evolutek/cartolutek-hardware/Hoop Interface/Output/hoop-interface.step

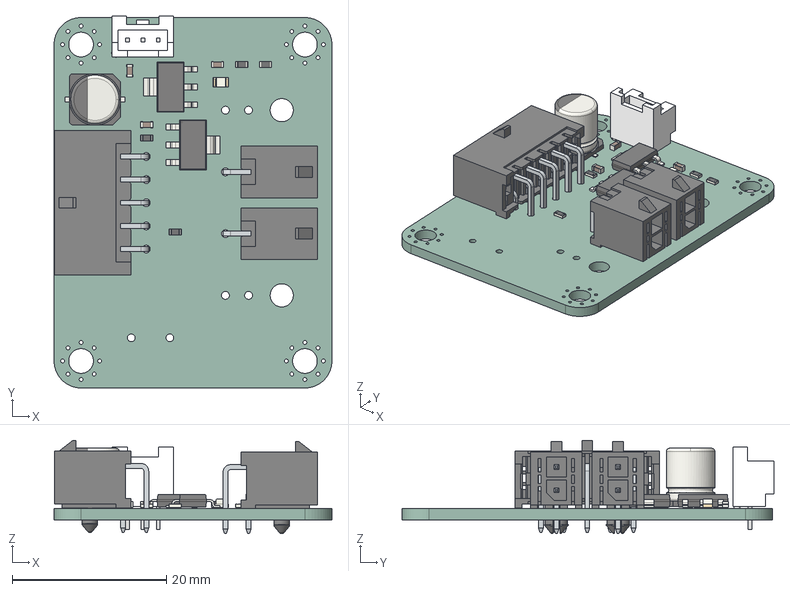
[picture p1: CAD file, 2026-03-06]
Hoop Interface/Output/hoop-interface.step
36.0 x 48.2 x 12.1 mm
6620xx21022_PIN_COURTE x 7
6620xx21022_PIN_LONGUE x 7
R_0603_1608Metric x 4
CP_Elec_6.3x7.7
SOT-223 x 2
C_0603_1608Metric x 3
LED_0805_2012Metric
B03B-PASK-1
hoop-interface_PCB
