evolutek/cartolutek-hardware/Mainboard/Output/Mainboard.pdf

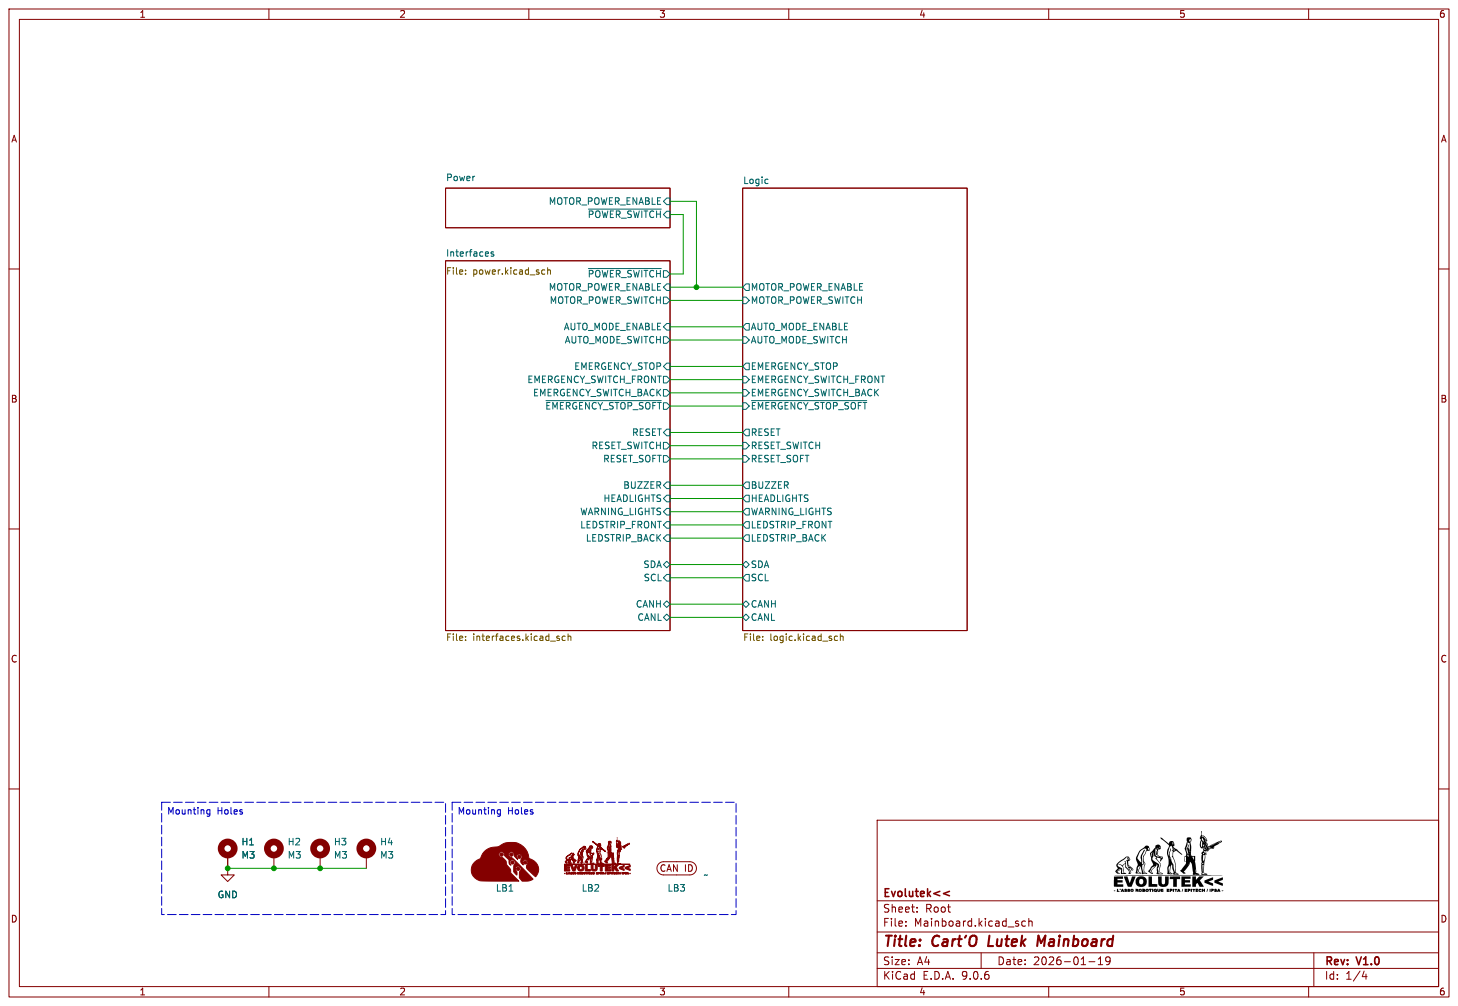
[picture p2: page 1]

~{POWER_SWITCH} Power File: power.kicad_sch MOTOR_POWER_ENABLE
Logic File: logic.kicad_sch CAN ID

LEDSTRIP_BACK
SDA CANL SCL CANH

File: Mainboard.kicad_sch Sheet: Root Evolutek<<

Id: 1/4 Title: Cart'O Lutek Mainboard

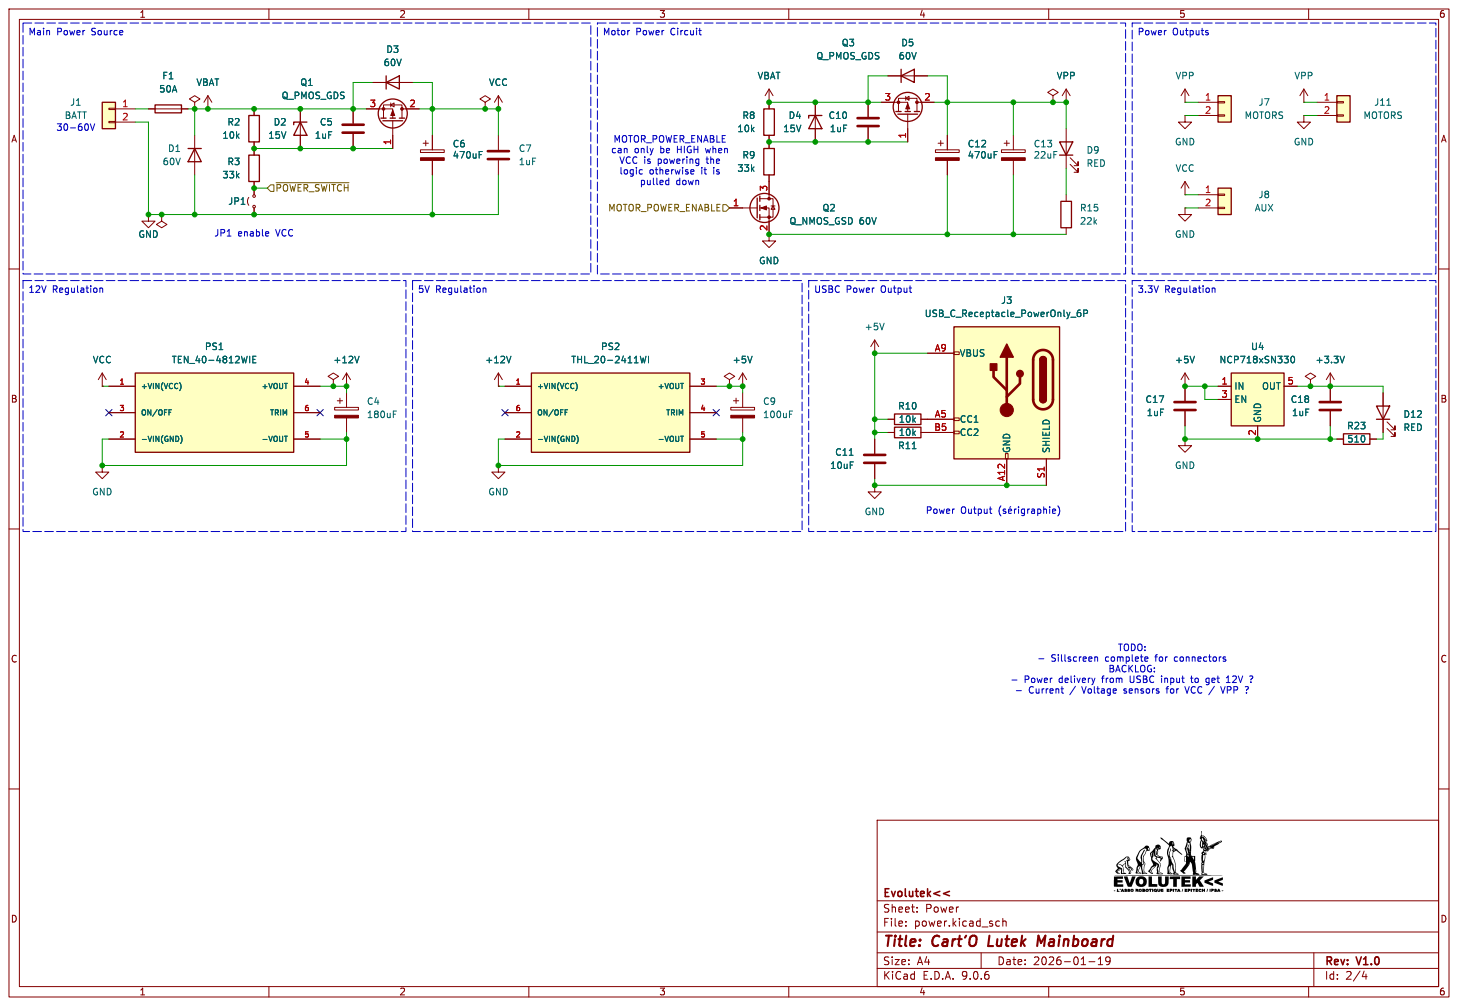
[picture p3: page 2]

- Current / Voltage sensors for VCC / VPP ? Power Output þÿ(sérigraphie) C6

can only be HIGH when VCC is powering the

File: power.kicad_sch Sheet: Power Evolutek<<

Id: 2/4 Title: Cart'O Lutek Mainboard

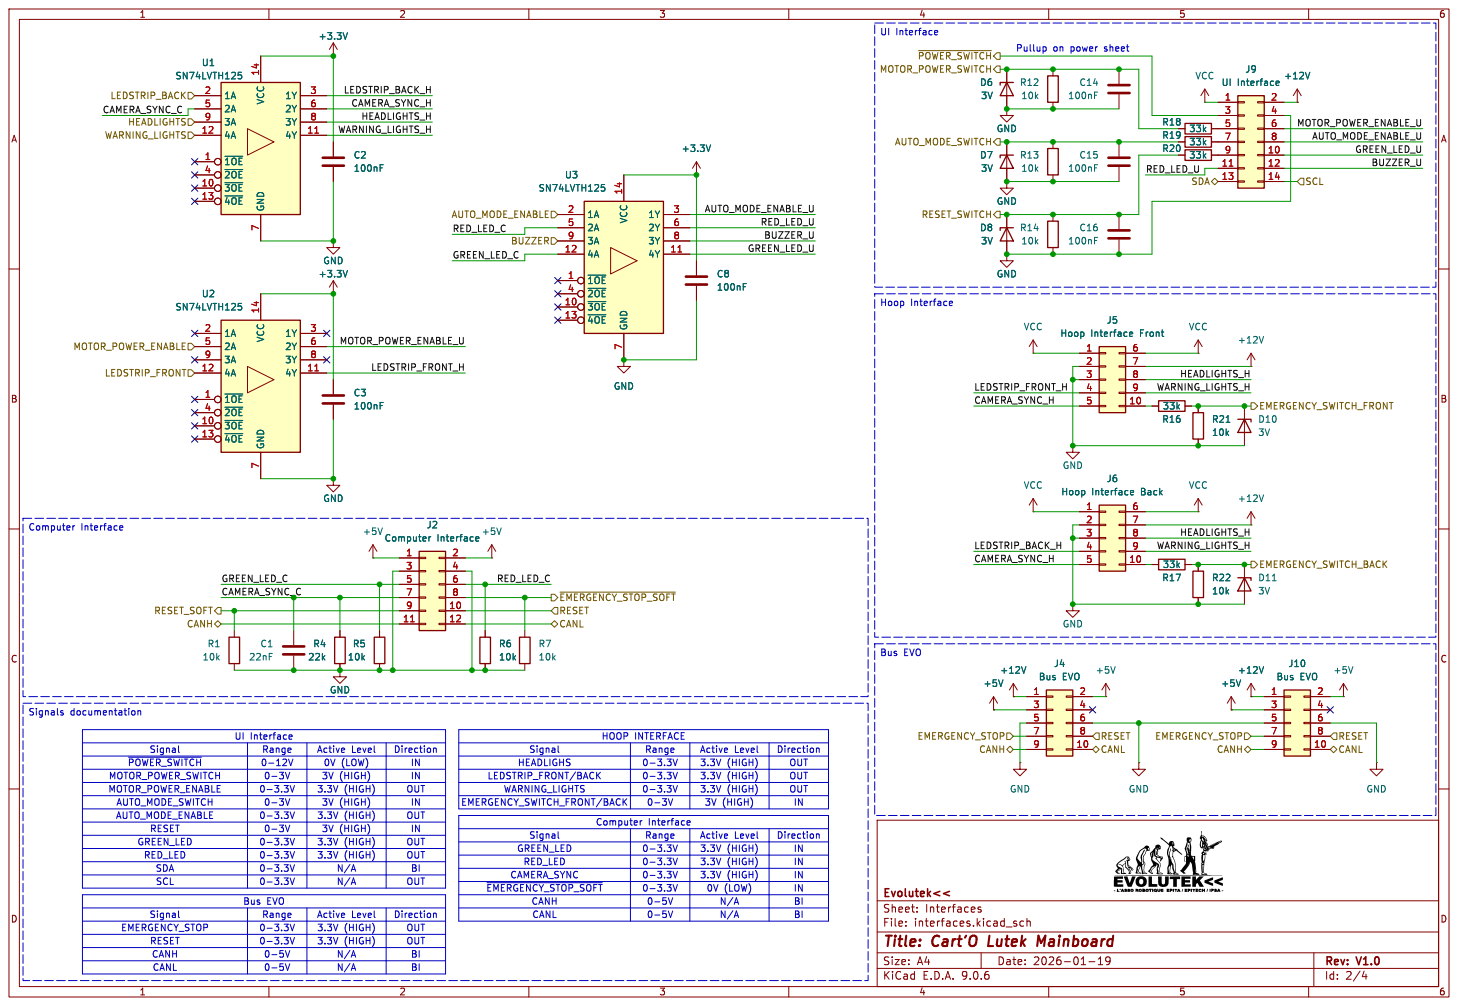
[picture p4: page 3]

Pullup on power sheet

Id: 2/4 Title: Cart'O Lutek Mainboard

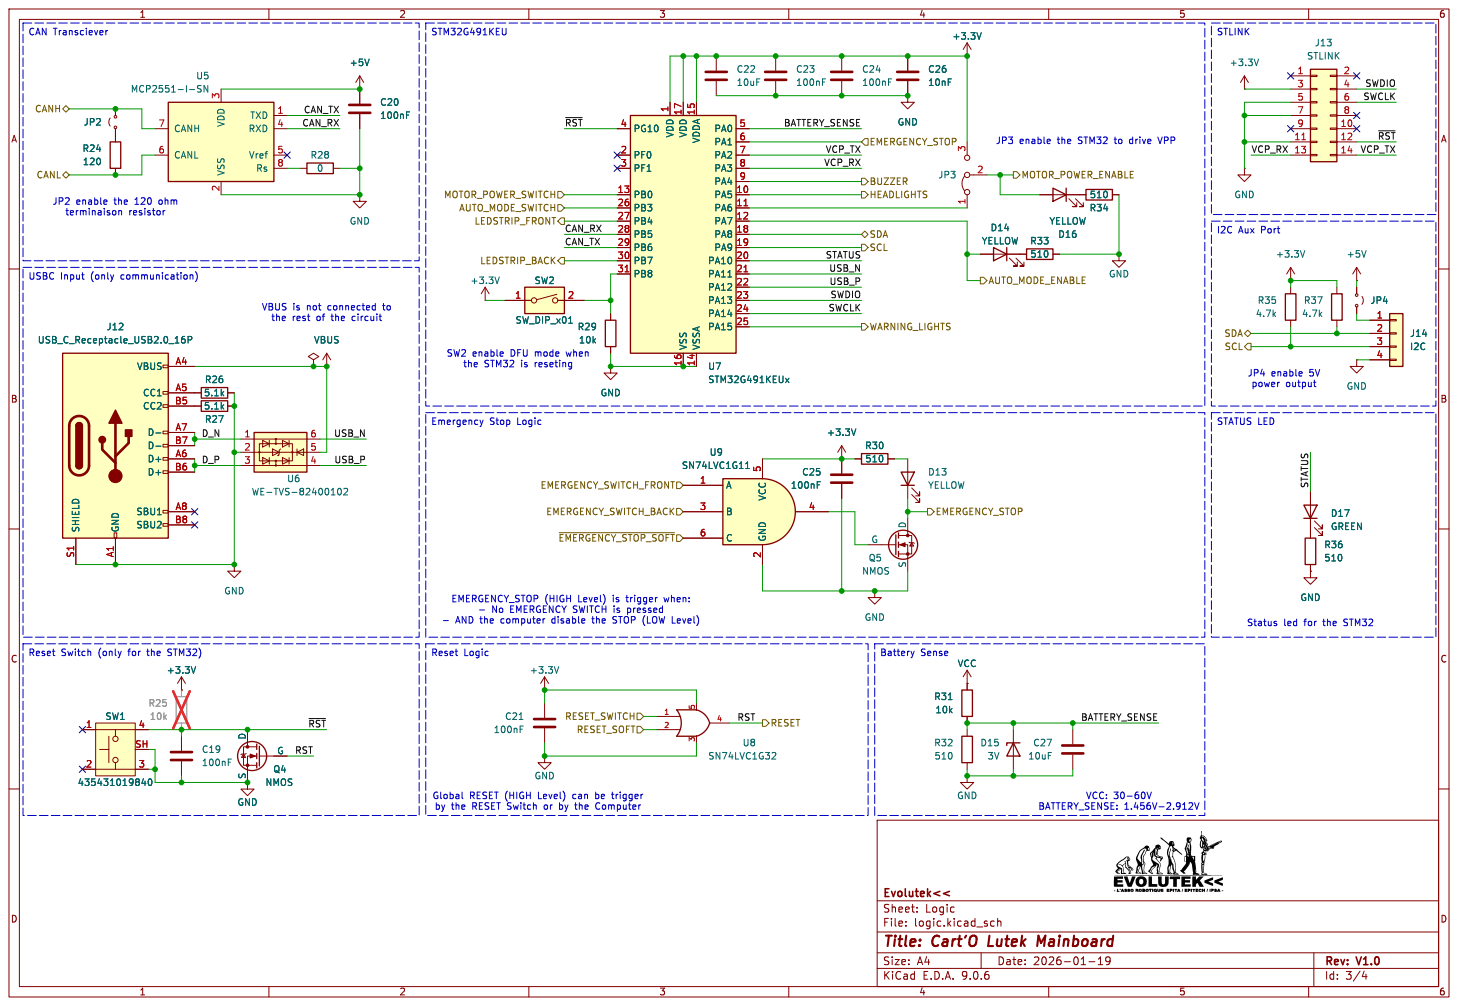
[picture p5: page 4]

1 VDD 17 VSS 16 VDDA 15 VSSA 14 PA0 5 PA1 6 PA2 7 PA3 8 PA4 9 PA5 10 PA6 11 PA7 12 PA8 18 PA9 19 PA10 20 PA11 21 PA12 22 PA13 23 PA14 24 PA15 25 J12 USB_C_Receptacle_USB2.0_16P SHIELD S1 GND A1 VBUS A4 CC1 A5 CC2 B5 D- A7 D- B7 D+ A6 D+ B6 SBU1 A8 SBU2 B8 R26

1 VDD 17 VSS 16 VDDA 15 VSSA 14 PA0 5 PA1 6 PA2 7 PA3 8 PA4 9 PA5 10 PA6 11 PA7 12 PA8 18 PA9 19 PA10 20 PA11 21 PA12 22 PA13 23 PA14 24 PA15 25 U7STM32G491KEUx GND

JP3 enable the STM32 to drive VPP

by the RESET Switch or by the Computer EMERGENCY_STOP (HIGH Level) is trigger when: - No EMERGENCY SWITCH is pressed

File: logic.kicad_sch Sheet: Logic Evolutek<<

Id: 3/4 Title: Cart'O Lutek Mainboard
