evolutek/cartolutek-hardware/Hoop Interface/Output/hoop-interface.pdf

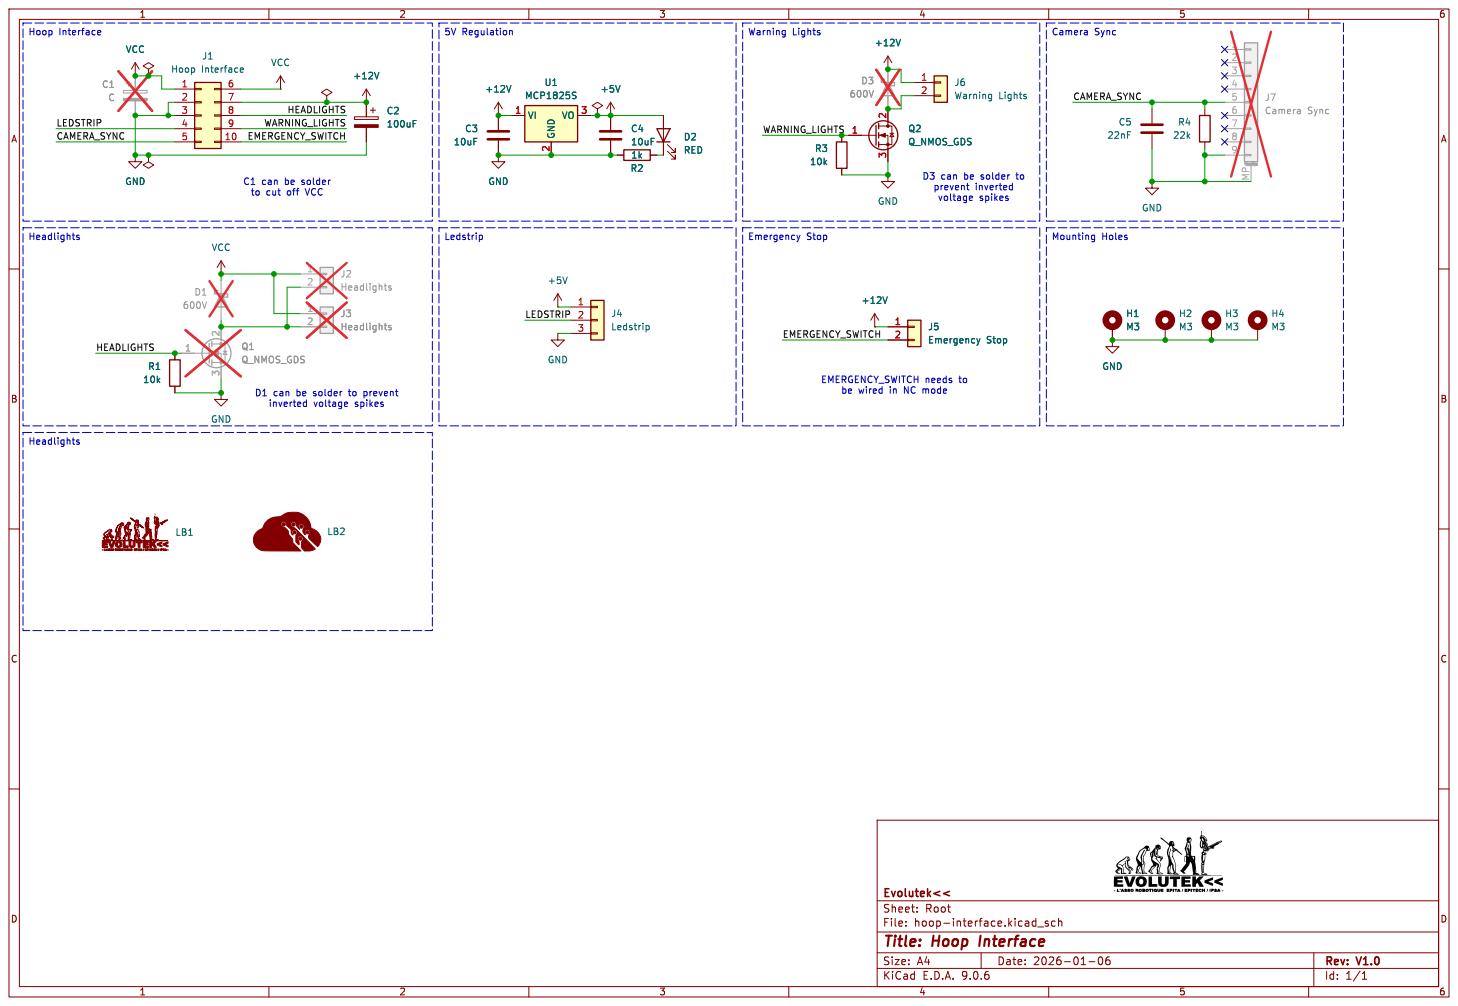
[picture p6: page 1]

be wired in NC mode D3 can be solder to

to cut off VCC

D1 can be solder to prevent

File: hoop-interface.kicad_sch Sheet: Root Evolutek<<

Id: 1/1 Title: Hoop Interface
