evolutek/cartolutek-hardware/RPI Interface/Output/Schematics.pdf

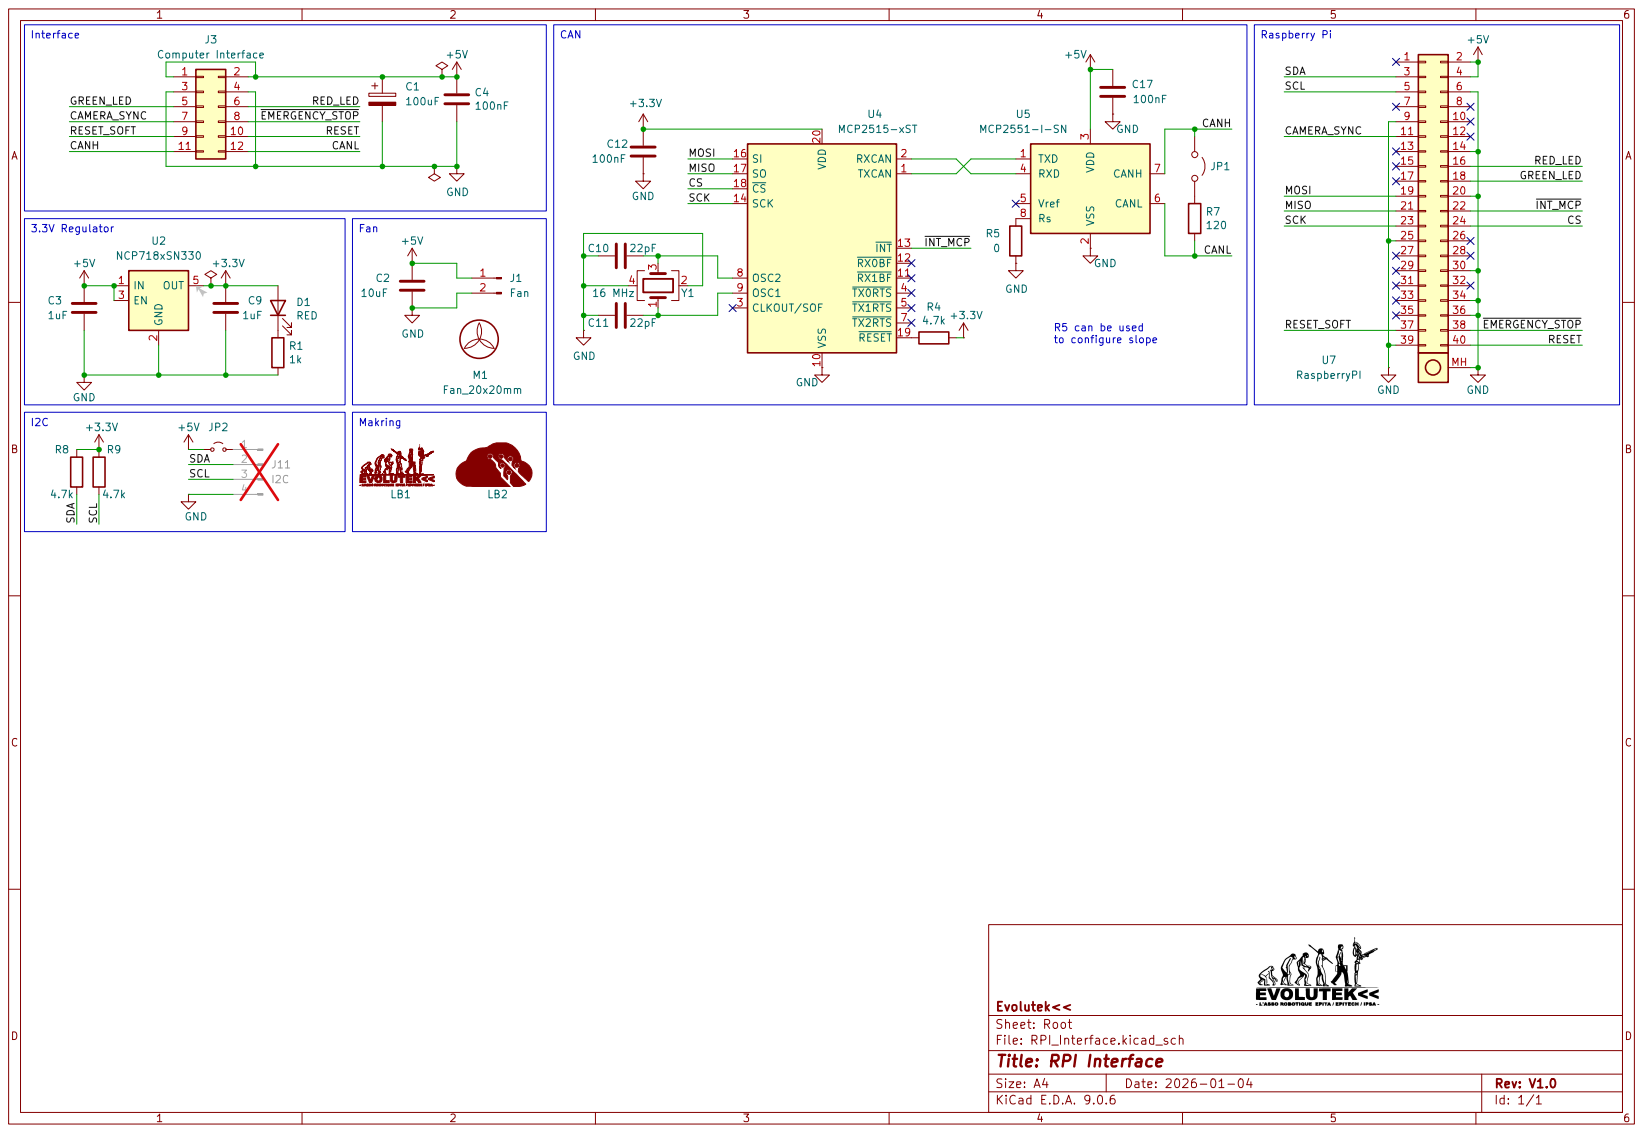
[picture p7: page 1]
