evolutek/cartolutek-hardware/UI Interface/Output/Schematics.pdf

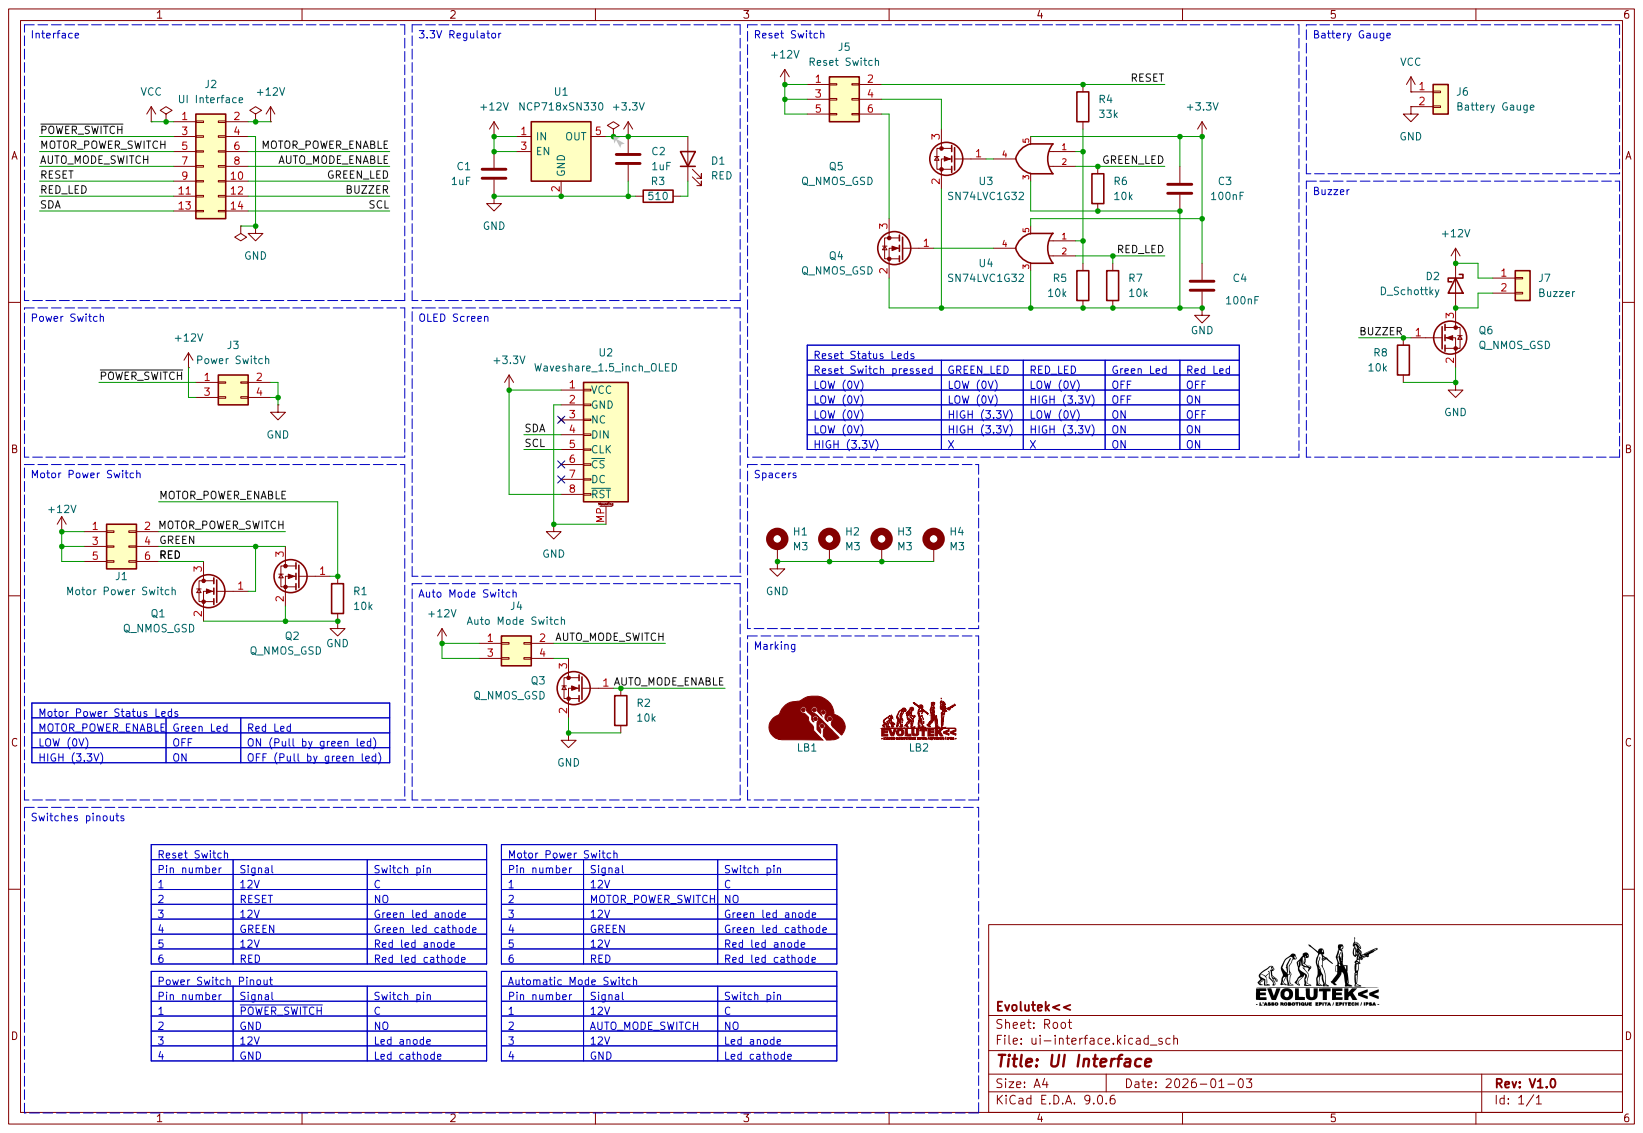
[picture p8: page 1]
