evolutek/cartolutek-hardware/Carte Moteur/Output/Schematics.pdf

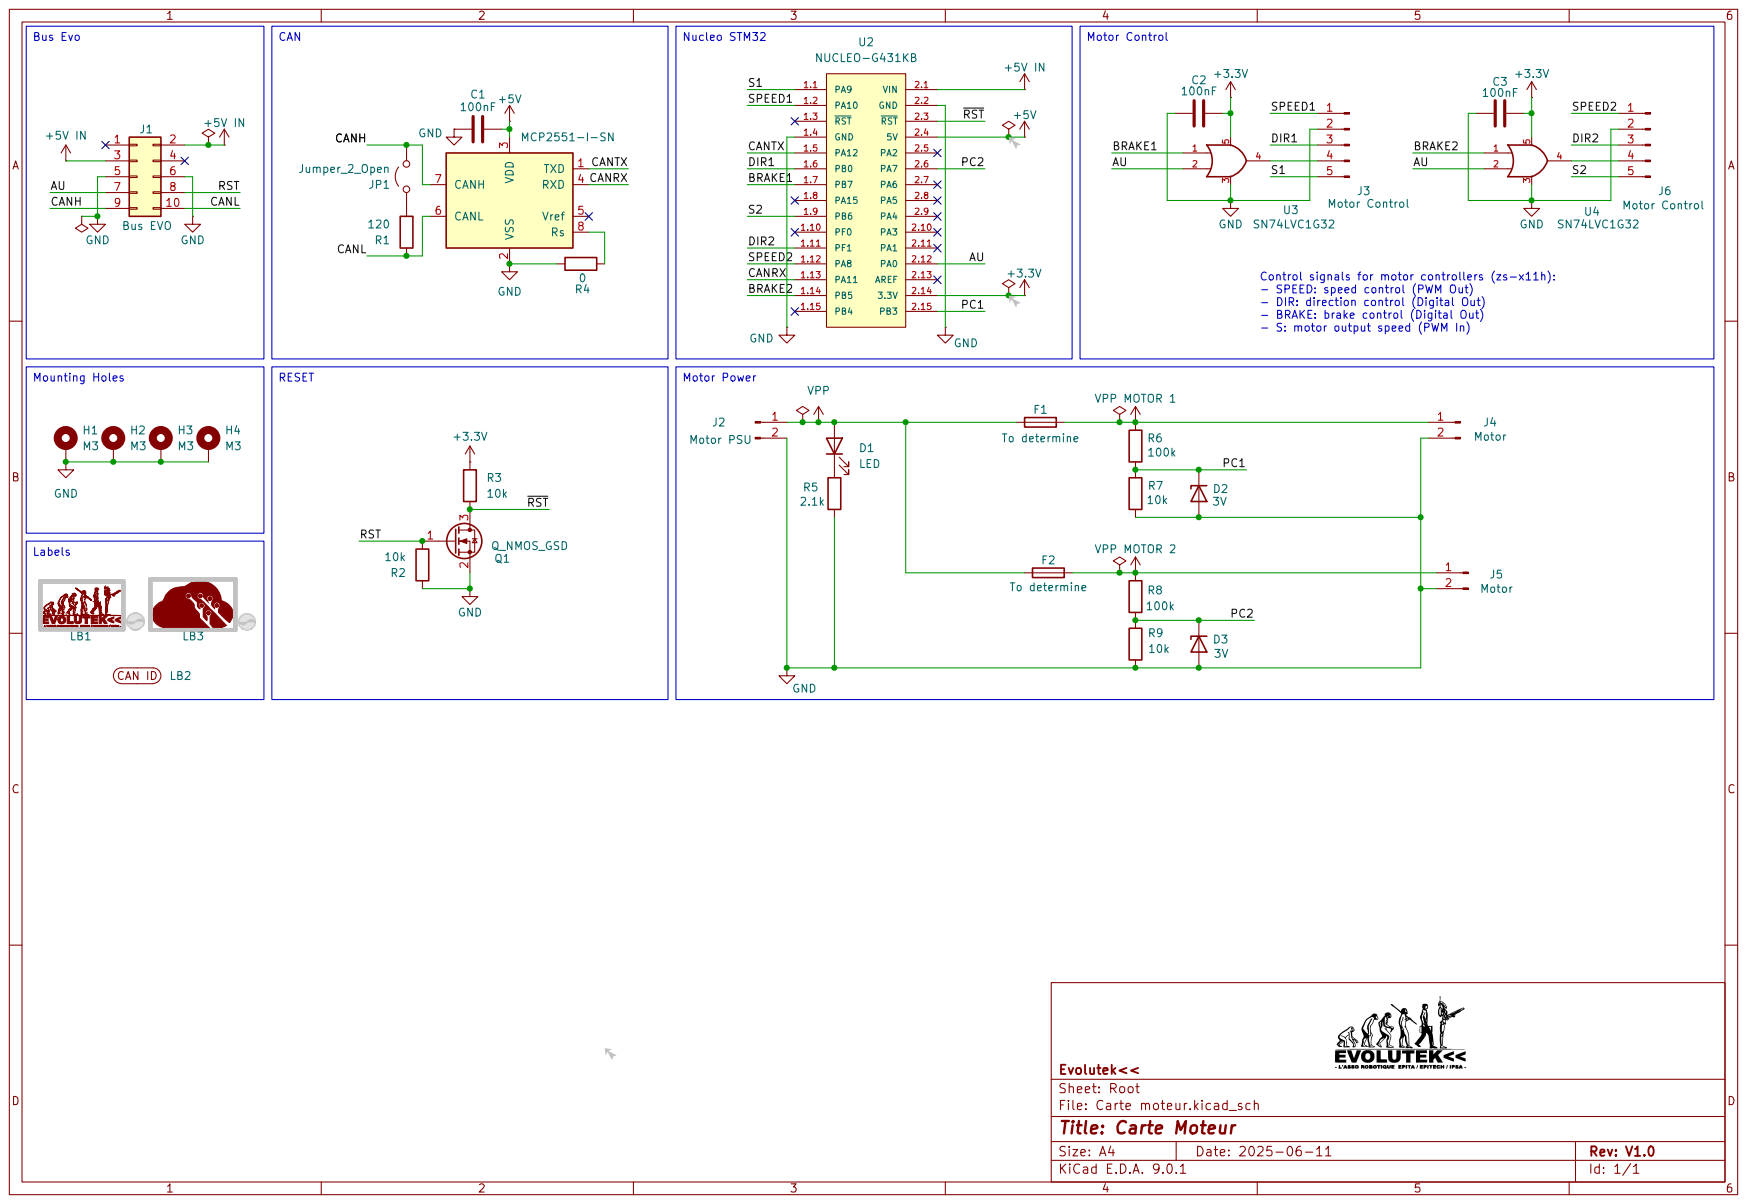
[picture p9: page 1]
