evolutek/cartolutek-hardware/Carte Moteur/Output/Board-Front.pdf

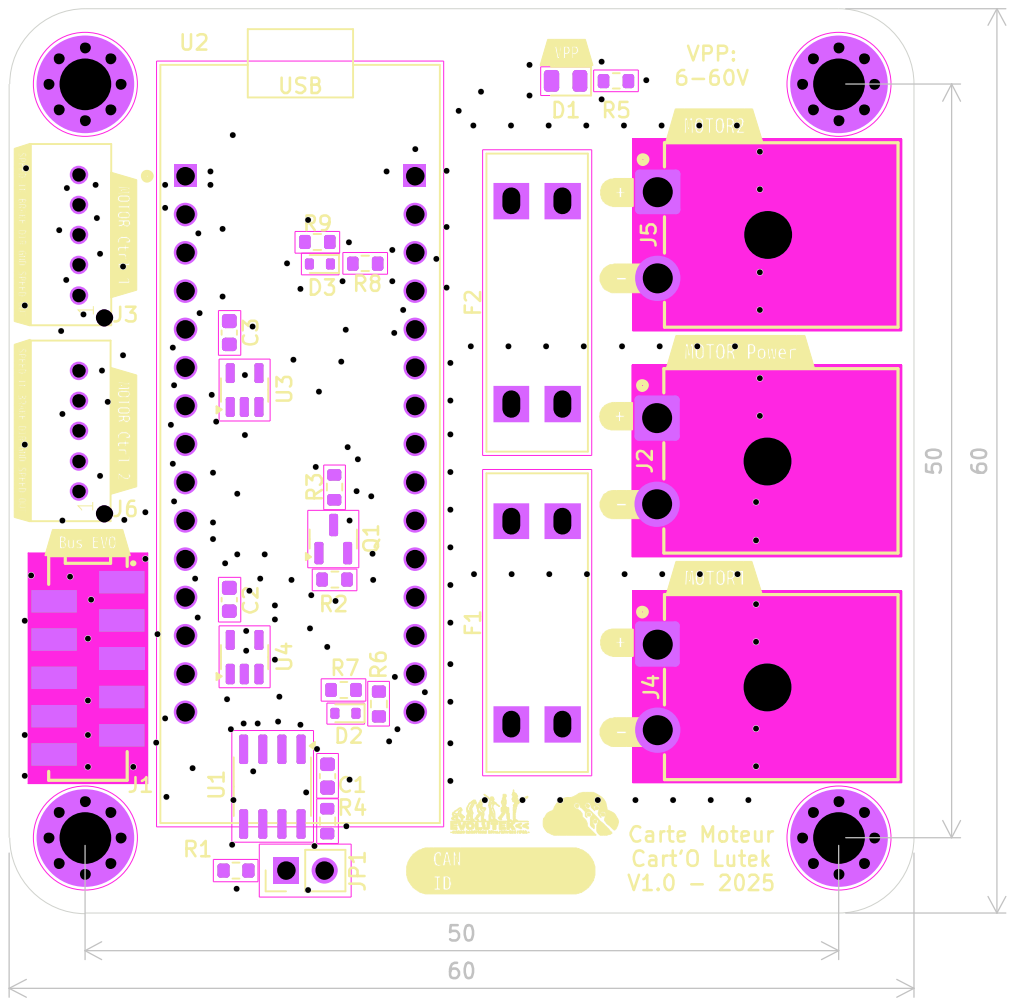
[picture p10: page 1]
