evolutek/cartolutek-hardware/Mainboard/Mainboard.kicad_pcb

## KiCad design Mainboard/Mainboard.kicad_pcb (2026-03-06)

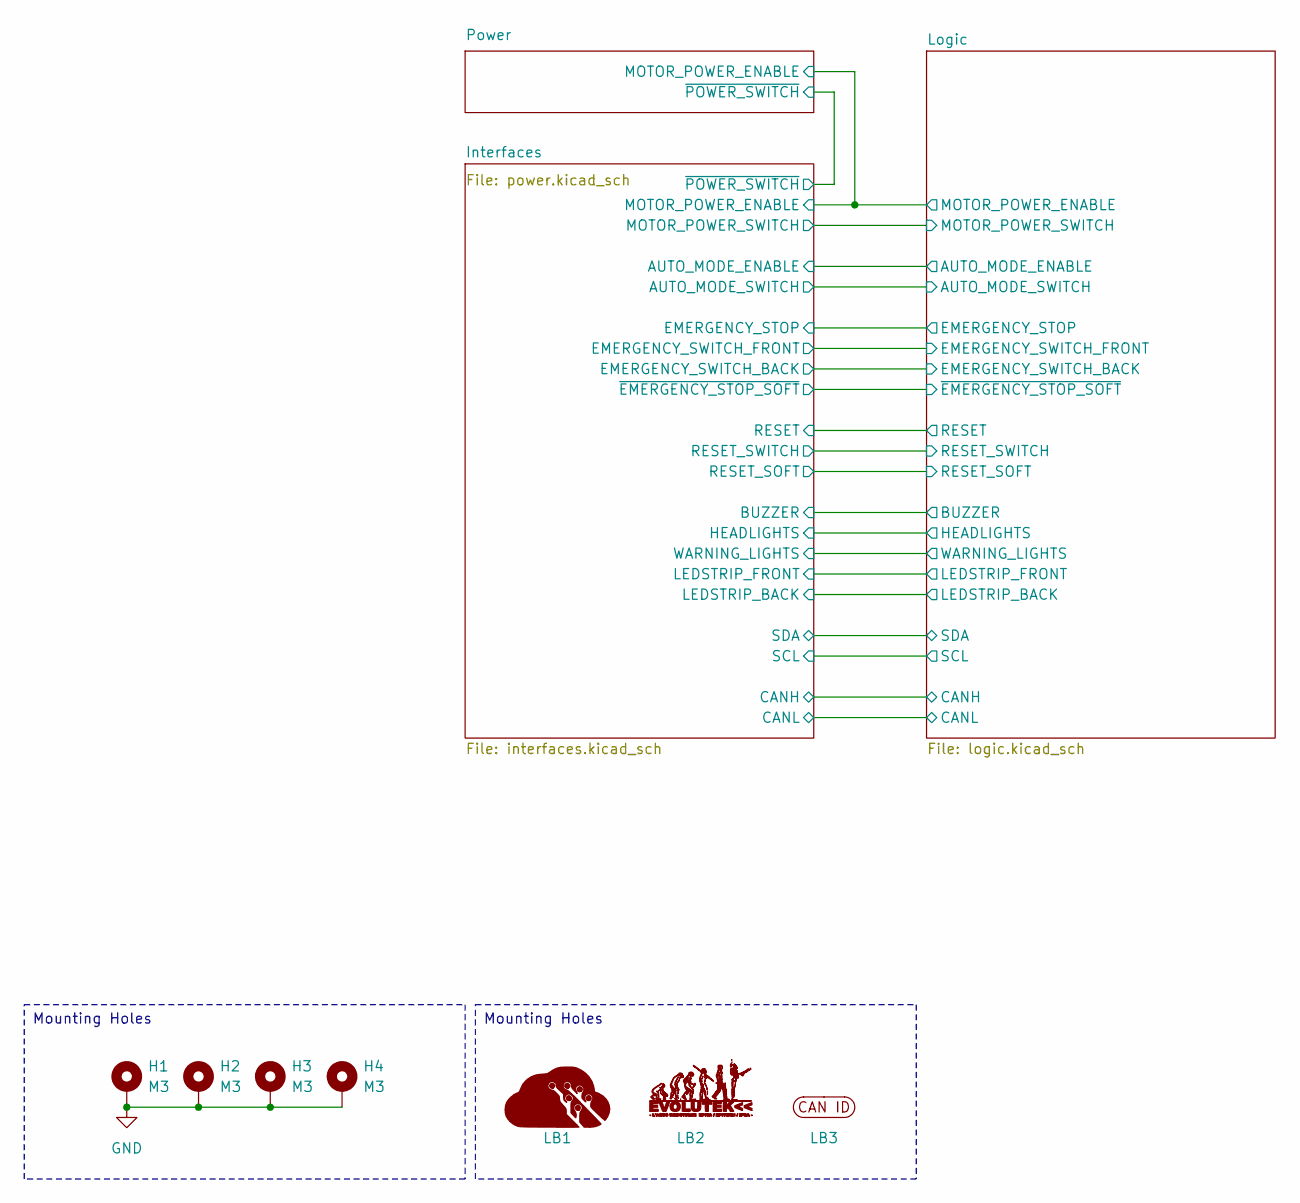
[picture p11: schematic Mainboard.kicad_sch, Cart'O Lutek Mainboard]

Parts:
H1, H2, H3, H4: M3; MountingHole_3.2mm_M3_Pad_Via
LB1: LOGO; Logo Aisler Min
LB2: LOGO; logo-evo-min
LB3: CAN ID Label

Connections:
GND: H1.1, H2.1, H3.1, H4.1; also elsewhere on the board

Notes on the sheet:
Mounting Holes

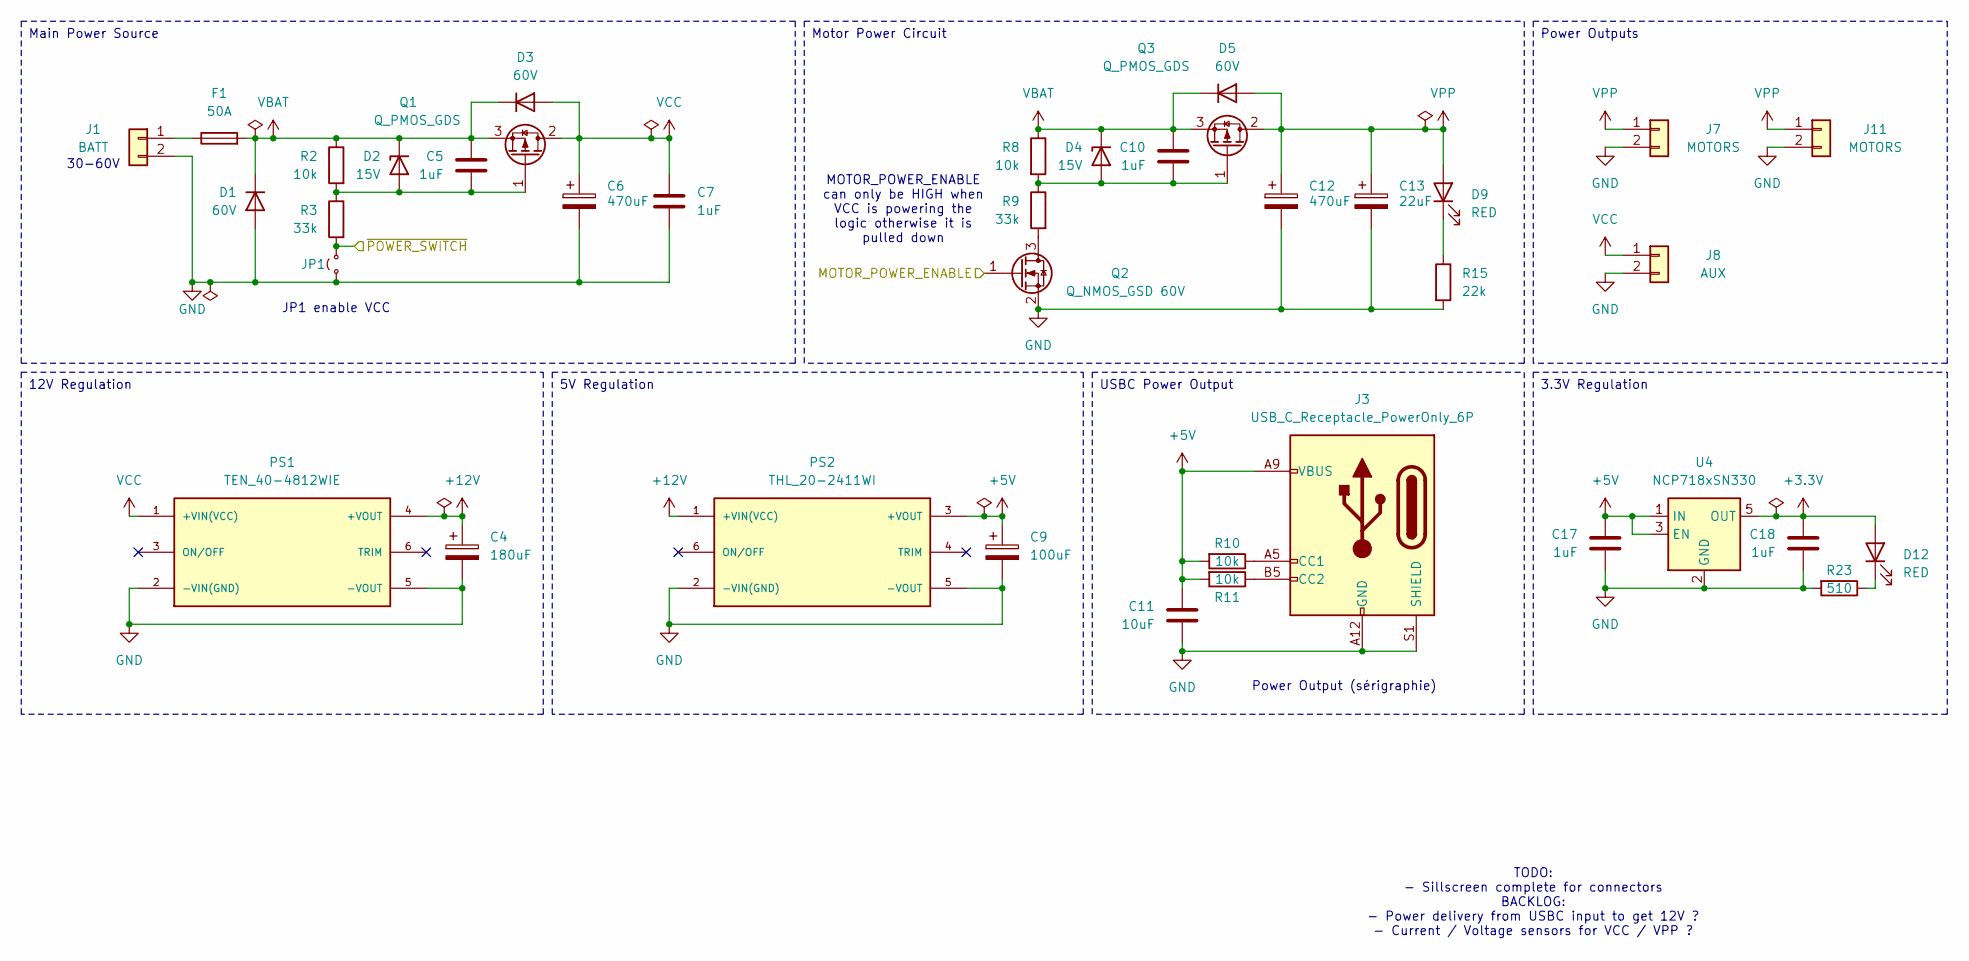
[picture p12: schematic power.kicad_sch, Cart'O Lutek Mainboard]

Parts:
C4: 180uF; CP_Radial_D10.0mm_P5.00mm
C5, C10, C17, C18: 1uF; C_0603_1608Metric
C6, C12: 470uF; CP_Radial_D12.5mm_P5.00mm
C7: 1uF; C_0805_2012Metric_Pad1.18x1.45mm_HandSolder
C9: 100uF; CP_Elec_6.3x7.7
C11: 10uF; C_0603_1608Metric
C13: 22uF; CP_Radial_D10.0mm_P5.00mm
D1, D3, D5: 60V; DO-214AB
D2, D4: 15V; D_SOD-523
D9, D12: RED; LED_0805_2012Metric
F1: 50A; FUSE_3557-2
J1: BATT; 657002140101
J3: USB_C_Receptacle_PowerOnly_6P; GCT_USB4125-GF-A_REVA2
J7, J11: MOTORS; 657002140101
J8: AUX; 657002140101
JP1: Jumper_2_Small_Open; PinHeader_1x02_P2.54mm_Vertical
PS1: TEN_40-4812WIE; TRACO_CONV_TEN; PARTREV January 27, 2021
PS2: THL_20-2411WI; TRACO_CONV_THL; PARTREV Jan 18, 2021
Q1, Q3: Q_PMOS_GDS; TO-263-2
Q2: Q_NMOS_GSD 60V; SOT-23
R2, R8, R10, R11: 10k; R_0603_1608Metric
R3, R9: 33k; R_0603_1608Metric
R15: 22k; R_0603_1608Metric
R23: 510; R_0603_1608Metric
U4: NCP718xSN330; SOT-23-5

Connections:
+3.3V: C18.1, D12.2 (A), U4.5 (OUT); also elsewhere on the board
+5V: C9.1, C11.1, C17.1, J3.A9 (VBUS), J3.B9 (VBUS), PS2.3 (+VOUT), R10.2, R11.2, U4.1 (IN), U4.3 (EN); also elsewhere on the board
+12V: C4.1, PS1.4 (+VOUT), PS2.1 (+VIN(VCC)); also elsewhere on the board
/Interfaces/MOTOR_POWER_ENABLE: Q2.1 (G); also elsewhere on the board
/Interfaces/~POWER_SWITCH: JP1.2 (B), R3.2; also elsewhere on the board
GND: C4.2, C6.2, C7.2, C9.2, C11.2, C12.2, C13.2, C17.2, C18.2, D1.2 (A), J1.2, J3.A12 (GND), J3.B12 (GND), J3.S1 (SHIELD), J7.2, J8.2, J11.2, JP1.1 (A), PS1.2 (-VIN(GND)), PS1.5 (-VOUT), PS2.2 (-VIN(GND)), PS2.5 (-VOUT), Q2.2 (S), R15.2, R23.2, U4.2 (GND); also elsewhere on the board
unnamed: C5.2, D2.2 (A), Q1.1 (G), R2.2, R3.1
unnamed: C10.2, D4.2 (A), Q3.1 (G), R8.2, R9.1
unnamed: D9.1 (K), R15.1
unnamed: D12.1 (K), R23.1
unnamed: F1.1, J1.1
unnamed: J3.A5 (CC1), R10.1
unnamed: J3.B5 (CC2), R11.1
unnamed: Q2.3 (D), R9.2
VBAT: C5.1, C10.1, D1.1 (K), D2.1 (K), D3.1 (K), D4.1 (K), D5.1 (K), F1.2, Q1.3 (S), Q3.3 (S), R2.1, R8.1
VCC: C6.1, C7.1, D3.2 (A), J8.1, PS1.1 (+VIN(VCC)), Q1.2 (D); also elsewhere on the board
VPP: C12.1, C13.1, D5.2 (A), D9.2 (A), J7.1, J11.1, Q3.2 (D)

Notes on the sheet:
Power Output (sérigraphie)
JP1 enable VCC
TODO: - Sillscreen complete for connectors BACKLOG: - Power delivery from USBC input to get 12V ? - Current / Voltage sensors for VCC / VPP ?
MOTOR_POWER_ENABLE can only be HIGH when VCC is powering the logic otherwise it is pulled down
30-60V
5V Regulation
Main Power Source
Power Outputs
Motor Power Circuit
USBC Power Output
3.3V Regulation
12V Regulation

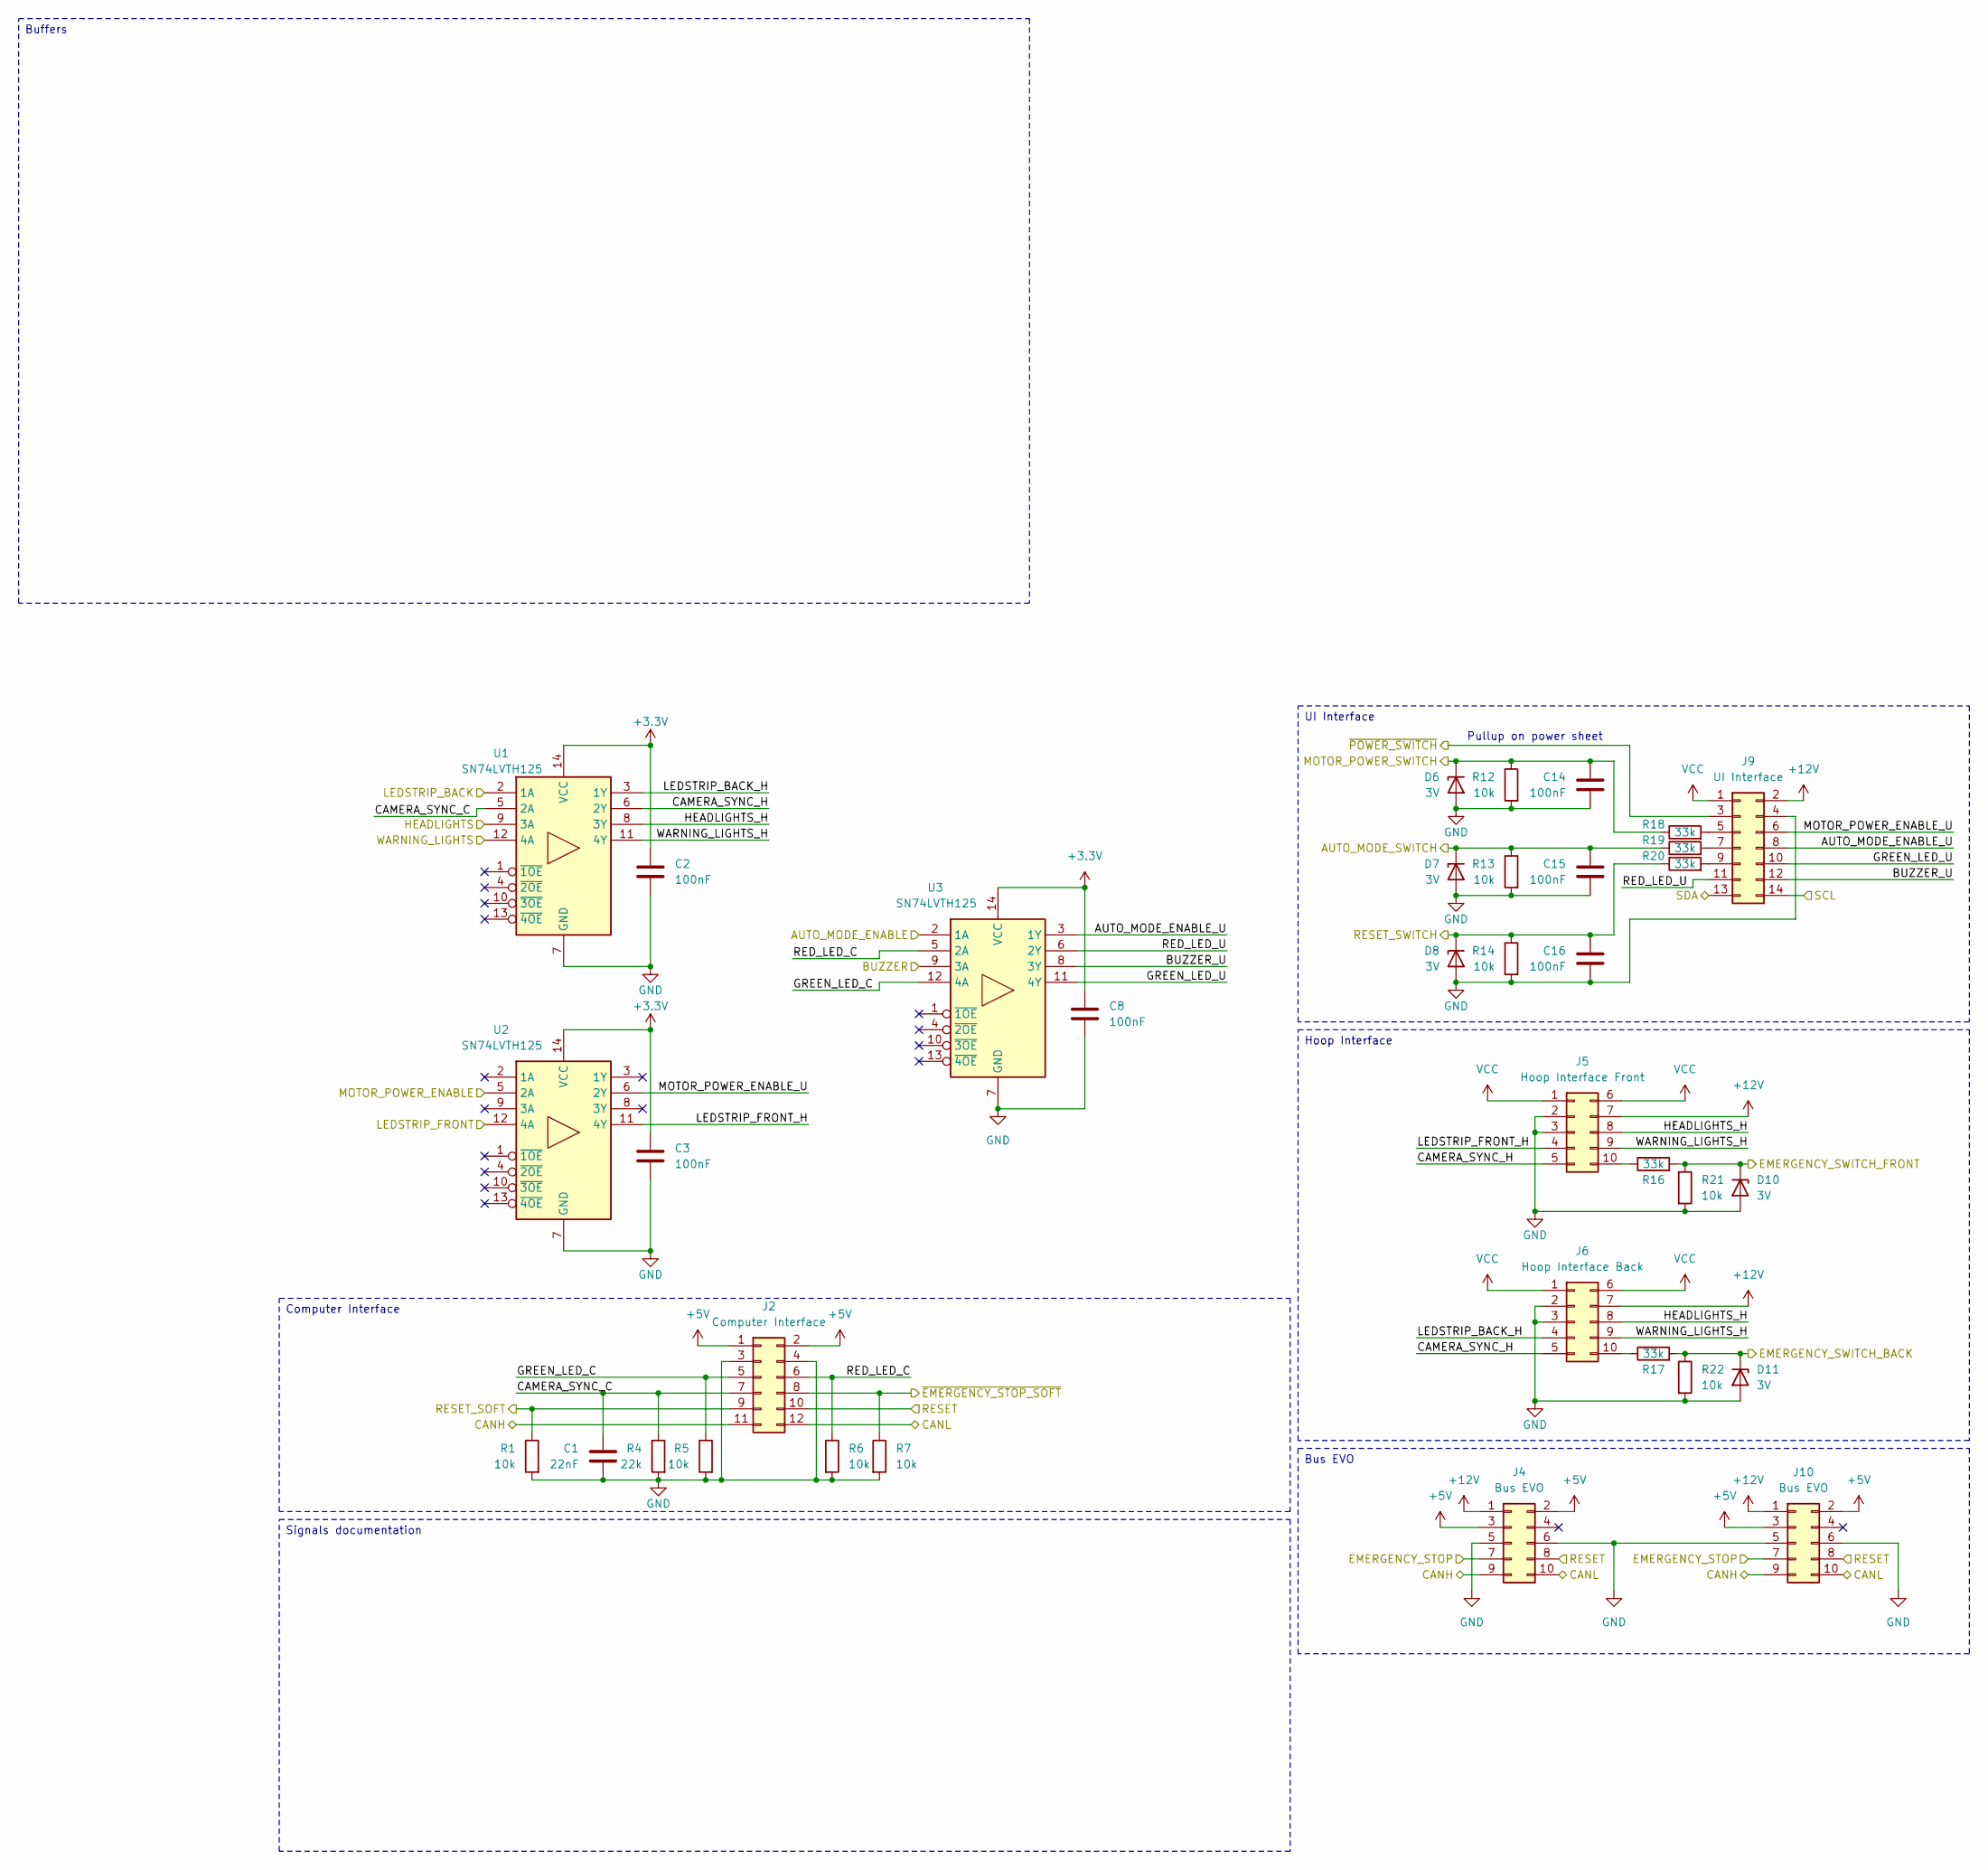
[picture p13: schematic interfaces.kicad_sch, Cart'O Lutek Mainboard]

Parts:
C1: 22nF; C_0603_1608Metric
C2, C3, C8, C14, C15, C16: 100nF; C_0603_1608Metric
D6, D7, D8, D10, D11: 3V; D_SOD-523
J2: Computer Interface; J_Wurth_WR-MM_690367281276
J4, J10: Bus EVO; 690367281076
J5: Hoop Interface Front; 66201021022
J6: Hoop Interface Back; 66201021022
J9: UI Interface; 690367281476
R1, R5, R6, R7, R12, R13, R14, R21, R22: 10k; R_0603_1608Metric
R4: 22k; R_0603_1608Metric
R16, R17, R18, R19, R20: 33k; R_0603_1608Metric
U1, U2, U3: SN74LVTH125; TSSOP-14_4.4x5mm_P0.65mm

Connections:
+3.3V: C2.1, C3.1, C8.1, U1.14 (VCC), U2.14 (VCC), U3.14 (VCC); also elsewhere on the board
+5V: J2.1, J2.2, J4.2, J4.3, J10.2, J10.3; also elsewhere on the board
+12V: J4.1, J5.7, J6.7, J9.2, J10.1; also elsewhere on the board
/Interfaces/AUTO_MODE_ENABLE: U3.2 (1A); also elsewhere on the board
/Interfaces/AUTO_MODE_ENABLE_U: J9.8, U3.3 (1Y)
/Interfaces/AUTO_MODE_SWITCH: C15.1, D7.1 (K), R13.1, R19.1; also elsewhere on the board
/Interfaces/BUZZER: U3.9 (3A); also elsewhere on the board
/Interfaces/BUZZER_U: J9.12, U3.8 (3Y)
/Interfaces/CAMERA_SYNC_C: C1.1, J2.7, R4.1, U1.5 (2A)
/Interfaces/CAMERA_SYNC_H: J5.5, J6.5, U1.6 (2Y)
/Interfaces/CANH: J2.11, J4.9, J10.9; also elsewhere on the board
/Interfaces/CANL: J2.12, J4.10, J10.10; also elsewhere on the board
/Interfaces/EMERGENCY_STOP: J4.7, J10.7; also elsewhere on the board
/Interfaces/EMERGENCY_SWITCH_BACK: D11.1 (K), R17.2, R22.1; also elsewhere on the board
/Interfaces/EMERGENCY_SWITCH_FRONT: D10.1 (K), R16.2, R21.1; also elsewhere on the board
/Interfaces/GREEN_LED_C: J2.5, R5.1, U3.12 (4A)
/Interfaces/GREEN_LED_U: J9.10, U3.11 (4Y)
/Interfaces/HEADLIGHTS: U1.9 (3A); also elsewhere on the board
/Interfaces/HEADLIGHTS_H: J5.8, J6.8, U1.8 (3Y)
/Interfaces/LEDSTRIP_BACK: U1.2 (1A); also elsewhere on the board
/Interfaces/LEDSTRIP_BACK_H: J6.4, U1.3 (1Y)
/Interfaces/LEDSTRIP_FRONT: U2.12 (4A); also elsewhere on the board
/Interfaces/LEDSTRIP_FRONT_H: J5.4, U2.11 (4Y)
/Interfaces/MOTOR_POWER_ENABLE: U2.5 (2A); also elsewhere on the board
/Interfaces/MOTOR_POWER_ENABLE_U: J9.6, U2.6 (2Y)
/Interfaces/MOTOR_POWER_SWITCH: C14.1, D6.1 (K), R12.1, R18.1; also elsewhere on the board
/Interfaces/RED_LED_C: J2.6, R6.1, U3.5 (2A)
/Interfaces/RED_LED_U: J9.11, U3.6 (2Y)
/Interfaces/RESET_SOFT: J2.9, R1.1; also elsewhere on the board
/Interfaces/RESET_SWITCH: C16.1, D8.1 (K), R14.1, R20.1; also elsewhere on the board
/Interfaces/SCL: J9.14; also elsewhere on the board
/Interfaces/SDA: J9.13; also elsewhere on the board
/Interfaces/WARNING_LIGHTS: U1.12 (4A); also elsewhere on the board
/Interfaces/WARNING_LIGHTS_H: J5.9, J6.9, U1.11 (4Y)
/Interfaces/~EMERGENCY_STOP_SOFT: J2.8, R7.1; also elsewhere on the board
/Interfaces/~POWER_SWITCH: J9.3; also elsewhere on the board
/Logic/RST: J2.10, J4.8, J10.8; also elsewhere on the board
GND: C1.2, C2.2, C3.2, C8.2, C14.2, C15.2, C16.2, D6.2 (A), D7.2 (A), D8.2 (A), D10.2 (A), D11.2 (A), J2.3, J2.4, J4.5, J4.6, J5.2, J5.3, J6.2, J6.3, J9.4, J10.5, J10.6, R1.2, R4.2, R5.2, R6.2, R7.2, R12.2, R13.2, R14.2, R21.2, R22.2, U1.7 (GND), U2.7 (GND), U3.7 (GND); also elsewhere on the board
unnamed: J5.10, R16.1
unnamed: J6.10, R17.1
unnamed: J9.5, R18.2
unnamed: J9.7, R19.2
unnamed: J9.9, R20.2
VCC: J5.1, J5.6, J6.1, J6.6, J9.1; also elsewhere on the board

Notes on the sheet:
Pullup on power sheet
Computer Interface
Bus EVO
Hoop Interface
UI Interface
Signals documentation
Buffers

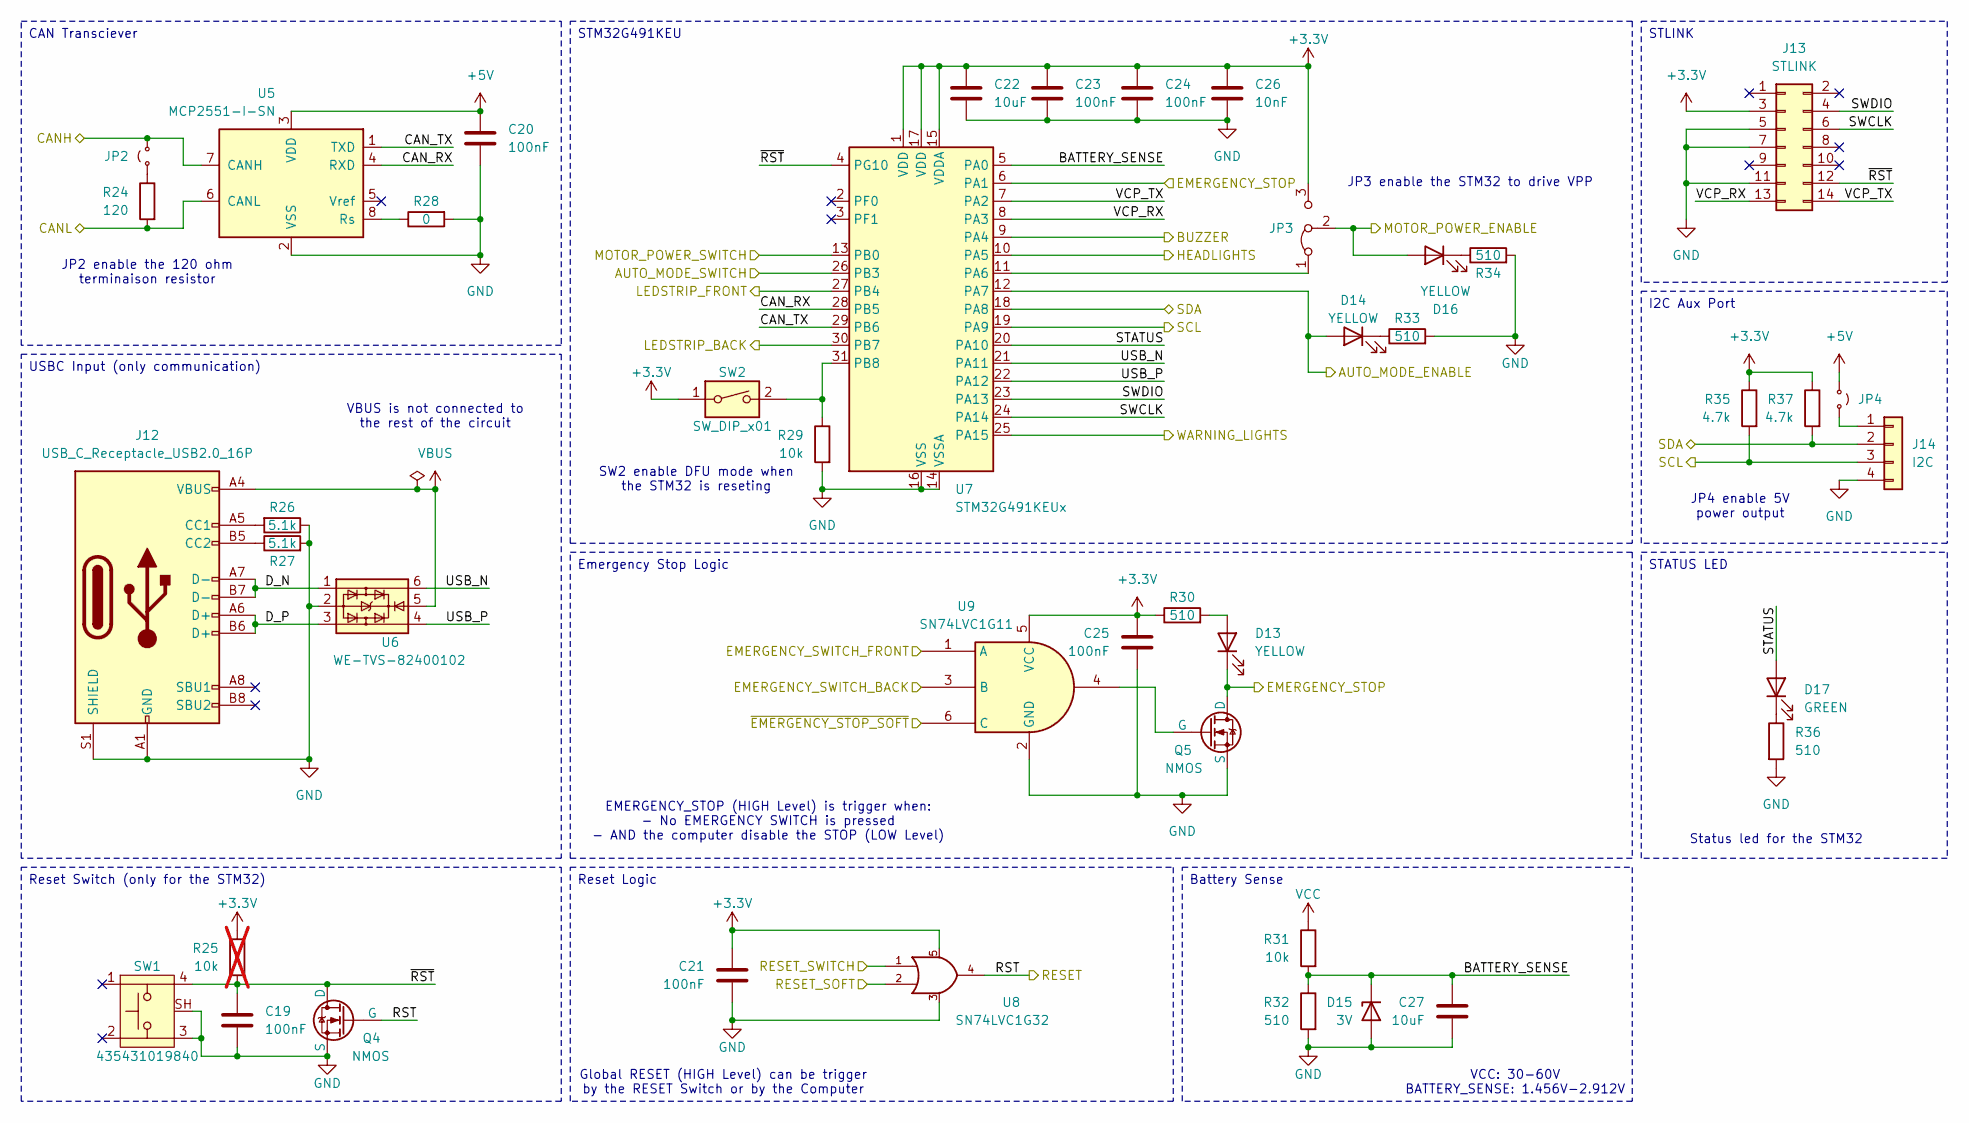
[picture p14: schematic logic.kicad_sch, Cart'O Lutek Mainboard]

Parts:
C19, C20, C21, C23, C24, C25: 100nF; C_0603_1608Metric
C22, C27: 10uF; C_0603_1608Metric
C26: 10nF; C_0603_1608Metric
D13, D14, D16: YELLOW; LED_0805_2012Metric
D15: 3V; D_SOD-523
D17: GREEN; LED_0805_2012Metric
J12: USB_C_Receptacle_USB2.0_16P; 629722000214
J13: STLINK; 62701420621
J14: I2C; B04B-PASK
JP2, JP4: Jumper_2_Small_Open; PinHeader_1x02_P2.54mm_Vertical
JP3: Jumper_3_Bridged12; PinHeader_1x03_P2.54mm_Vertical
Q4, Q5: NMOS; SOT-23
R24: 120; R_0603_1608Metric
R25: 10k; R_0603_1608Metric; not fitted
R26, R27: 5.1k; R_0603_1608Metric
R28: 0; R_0603_1608Metric
R29, R31: 10k; R_0603_1608Metric
R30, R32, R33, R34, R36: 510; R_0603_1608Metric
R35, R37: 4.7k; R_0603_1608Metric
SW1: 435431019840
SW2: SW_DIP_x01; SW_DIP_SPSTx01_Slide_6.7x4.1mm_W7.62mm_P2.54mm_LowProfile
U5: MCP2551-I-SN; SOIC-8_3.9x4.9mm_P1.27mm
U6: WE-TVS-82400102; SOT-23-6
U7: STM32G491KEUx; QFN-32-1EP_5x5mm_P0.5mm_EP3.45x3.45mm-Without thermal pad
U8: SN74LVC1G32; SOT-23-5
U9: SN74LVC1G11; SOT-23-6

Connections:
+3.3V: C21.1, C22.1, C23.1, C24.1, C25.1, C26.1, J13.3, JP3.3 (B), R25.1, R30.1, R35.1, R37.1, SW2.1, U7.1 (VDD), U7.15 (VDDA), U7.17 (VDD), U8.5 (VCC), U9.5 (VCC); also elsewhere on the board
+5V: C20.1, JP4.1 (A), U5.3 (VDD); also elsewhere on the board
/Interfaces/AUTO_MODE_ENABLE: D14.2 (A), U7.12 (PA7); also elsewhere on the board
/Interfaces/AUTO_MODE_SWITCH: U7.26 (PB3); also elsewhere on the board
/Interfaces/BUZZER: U7.9 (PA4); also elsewhere on the board
/Interfaces/CANH: JP2.1 (A), U5.7 (CANH); also elsewhere on the board
/Interfaces/CANL: R24.2, U5.6 (CANL); also elsewhere on the board
/Interfaces/EMERGENCY_STOP: D13.1 (K), Q5.1 (D), U7.6 (PA1); also elsewhere on the board
/Interfaces/EMERGENCY_SWITCH_BACK: U9.3 (B); also elsewhere on the board
/Interfaces/EMERGENCY_SWITCH_FRONT: U9.1 (A); also elsewhere on the board
/Interfaces/HEADLIGHTS: U7.10 (PA5); also elsewhere on the board
/Interfaces/LEDSTRIP_BACK: U7.30 (PB7); also elsewhere on the board
/Interfaces/LEDSTRIP_FRONT: U7.27 (PB4); also elsewhere on the board
/Interfaces/MOTOR_POWER_ENABLE: D16.2 (A), JP3.2 (C); also elsewhere on the board
/Interfaces/MOTOR_POWER_SWITCH: U7.13 (PB0); also elsewhere on the board
/Interfaces/RESET_SOFT: U8.2 (B); also elsewhere on the board
/Interfaces/RESET_SWITCH: U8.1 (A); also elsewhere on the board
/Interfaces/SCL: J14.3, R35.2, U7.19 (PA9); also elsewhere on the board
/Interfaces/SDA: J14.2, R37.2, U7.18 (PA8); also elsewhere on the board
/Interfaces/WARNING_LIGHTS: U7.25 (PA15); also elsewhere on the board
/Interfaces/~EMERGENCY_STOP_SOFT: U9.6 (C); also elsewhere on the board
/Logic/BATTERY_SENSE: C27.1, D15.1 (K), R31.2, R32.1, U7.5 (PA0)
/Logic/CAN_RX: U5.4 (RXD), U7.28 (PB5)
/Logic/CAN_TX: U5.1 (TXD), U7.29 (PB6)
/Logic/D_N: J12.A7 (D-), J12.B7 (D-), U6.1
/Logic/D_P: J12.A6 (D+), J12.B6 (D+), U6.3
/Logic/RST: Q4.2 (G), U8.4 (S); also elsewhere on the board
/Logic/STATUS: D17.2 (A), U7.20 (PA10)
/Logic/SWCLK: J13.6, U7.24 (PA14)
/Logic/SWDIO: J13.4, U7.23 (PA13)
/Logic/USB_N: U6.6, U7.21 (PA11)
/Logic/USB_P: U6.4, U7.22 (PA12)
/Logic/VCP_RX: J13.13, U7.8 (PA3)
/Logic/VCP_TX: J13.14, U7.7 (PA2)
/Logic/~RST: C19.1, J13.12, Q4.1 (D), R25.2, SW1.4, U7.4 (PG10)
GND: C19.2, C20.2, C21.2, C22.2, C23.2, C24.2, C25.2, C26.2, C27.2, D15.2 (A), J12.A1 (GND), J12.A12 (GND), J12.B1 (GND), J12.B12 (GND), J12.S1 (SHIELD), J13.5, J13.7, J13.11, J14.4, Q4.3 (S), Q5.3 (S), R26.1, R27.2, R28.2, R29.2, R32.2, R33.2, R34.2, R36.2, SW1.3, SW1.SH, U5.2 (VSS), U6.2, U7.14 (VSSA), U7.16 (VSS), U7.32 (VSS), U8.3 (GND), U9.2 (GND); also elsewhere on the board
unnamed: D13.2 (A), R30.2
unnamed: D14.1 (K), R33.1
unnamed: D16.1 (K), R34.1
unnamed: D17.1 (K), R36.1
unnamed: J12.A5 (CC1), R26.2
unnamed: J12.B5 (CC2), R27.1
unnamed: J14.1, JP4.2 (B)
unnamed: JP2.2 (B), R24.1
unnamed: JP3.1 (A), U7.11 (PA6)
unnamed: Q5.2 (G), U9.4
unnamed: R28.1, U5.8 (Rs)
unnamed: R29.1, SW2.2, U7.31 (PB8)
VBUS: J12.A4 (VBUS), J12.A9 (VBUS), J12.B4 (VBUS), J12.B9 (VBUS), U6.5
VCC: R31.1; also elsewhere on the board

Notes on the sheet:
JP3 enable the STM32 to drive VPP
SW2 enable DFU mode when the STM32 is reseting
Status led for the STM32
JP4 enable 5V power output
VBUS is not connected to the rest of the circuit
EMERGENCY_STOP (HIGH Level) is trigger when: - No EMERGENCY SWITCH is pressed - AND the computer disable the STOP (LOW Level)
VCC: 30-60V BATTERY_SENSE: 1.456V-2.912V
JP2 enable the 120 ohm terminaison resistor
Global RESET (HIGH Level) can be trigger by the RESET Switch or by the Computer
Reset Logic
STM32G491KEU
STATUS LED
CAN Transciever
I2C Aux Port
Battery Sense
STLINK
Emergency Stop Logic
USBC Input (only communication)
Reset Switch (only for the STM32)

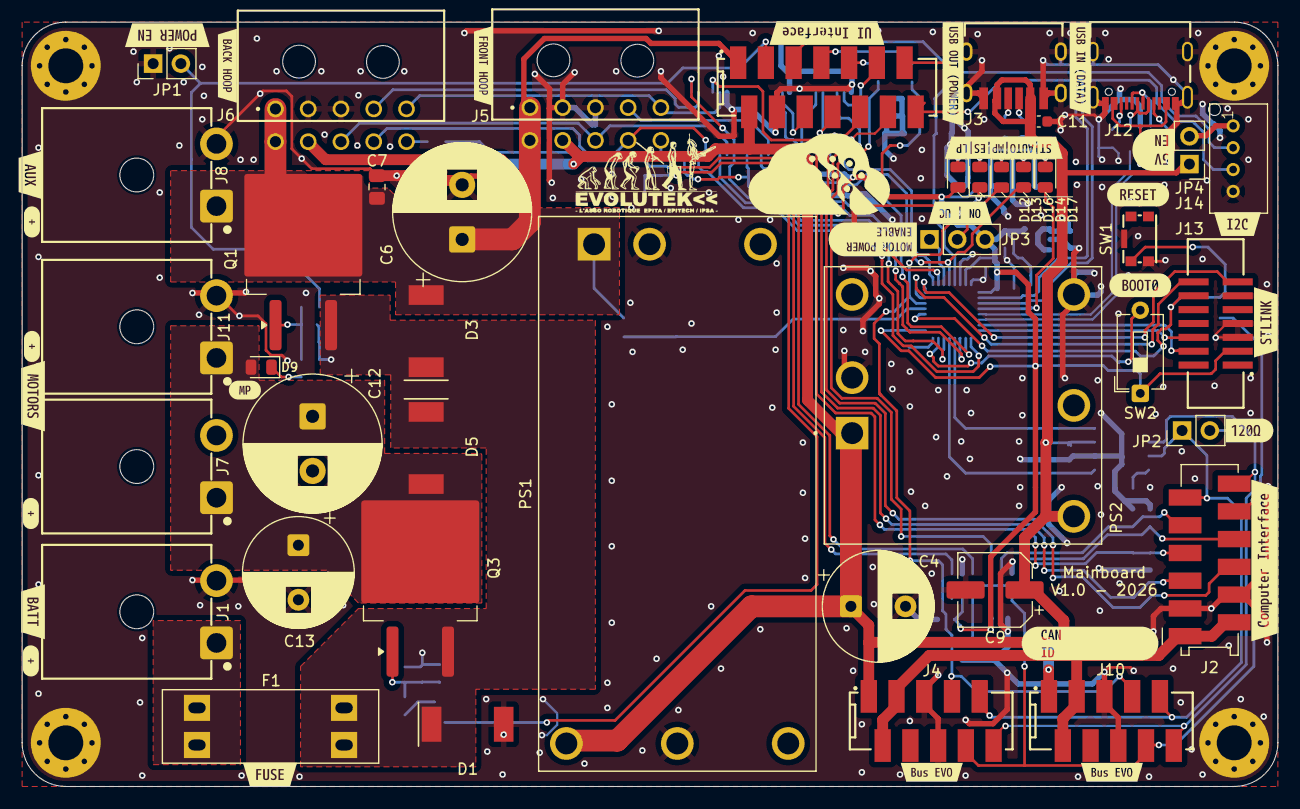
[picture p15: board Mainboard.kicad_pcb from above]

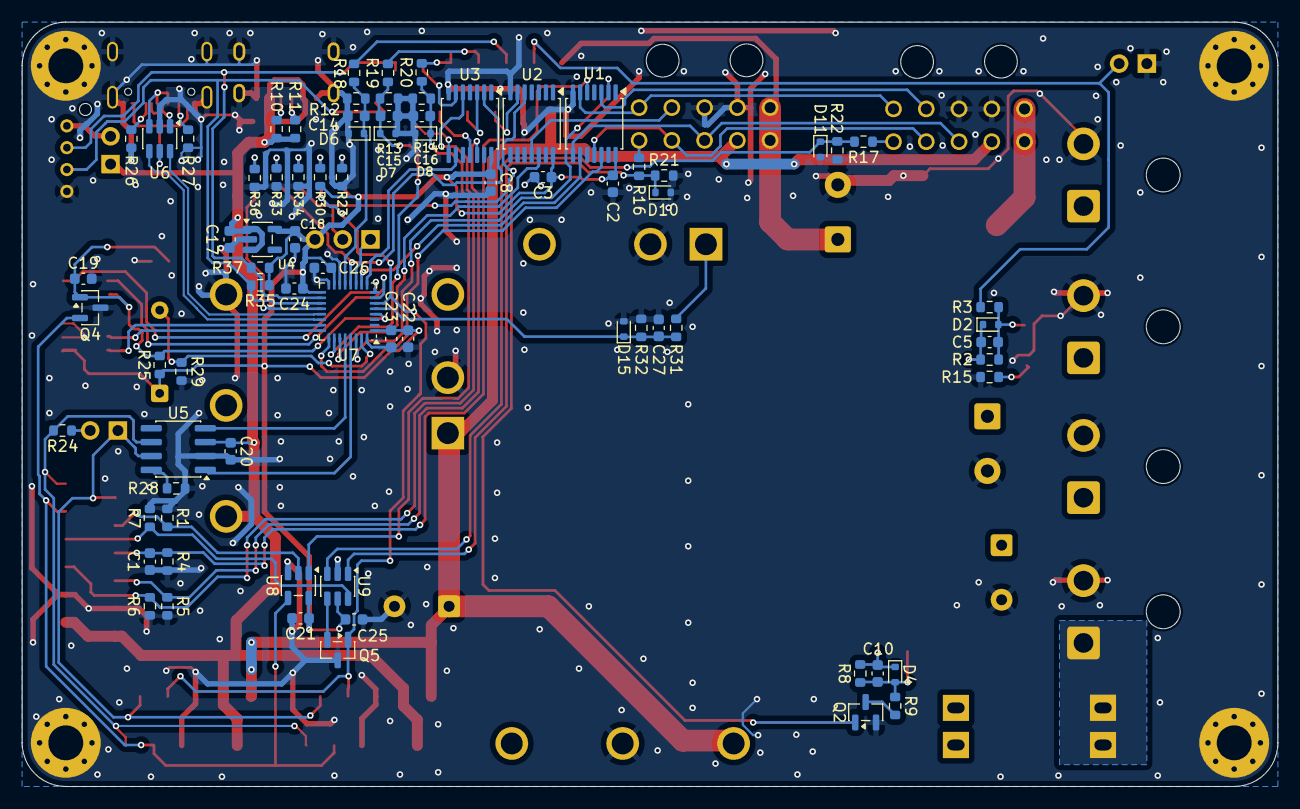
[picture p16: board Mainboard.kicad_pcb from below]

Board: 2 copper layers, 115.0 x 70.0 mm, 152 parts (77 on the bottom side), 80 nets.

Other parts of the board:
kibuzzard-696E6DCC, kibuzzard-696E6DCC#2: G***; kibuzzard-696E6DCC
kibuzzard-696E6E00: G***; kibuzzard-696E6E00
kibuzzard-696E6E38: G***; kibuzzard-696E6E38
kibuzzard-696E72E5: G***; kibuzzard-696E72E5
kibuzzard-696E711F: G***; kibuzzard-696E711F
kibuzzard-696E714D: G***; kibuzzard-696E714D
kibuzzard-696E735A: G***; kibuzzard-696E735A
kibuzzard-696E7025: G***; kibuzzard-696E7025
kibuzzard-696E7036: G***; kibuzzard-696E7036
kibuzzard-696E7098: G***; kibuzzard-696E7098
kibuzzard-696E7298: G***; kibuzzard-696E7298
kibuzzard-696E7408: G***; kibuzzard-696E7408
kibuzzard-696E7410: G***; kibuzzard-696E7410
kibuzzard-696EAE60: G***; kibuzzard-696EAE60
kibuzzard-696EAF2F: G***; kibuzzard-696EAF2F
kibuzzard-696EAF7E: G***; kibuzzard-696EAF7E
kibuzzard-696EAF66: G***; kibuzzard-696EAF66
kibuzzard-696EB33E, kibuzzard-696EB33E#2, kibuzzard-696EB33E#3, kibuzzard-696EB33E#4: G***; kibuzzard-696EB33E
kibuzzard-696554A0: G***; kibuzzard-696554A0
kibuzzard-696556D5: G***; kibuzzard-696556D5
kibuzzard-696556EB: G***; kibuzzard-696556EB
kibuzzard-69655432: G***; kibuzzard-69655432
kibuzzard-69655458: G***; kibuzzard-69655458
