evolutek/cartolutek-hardware/Hoop Interface/hoop-interface.kicad_pcb

## KiCad design Hoop Interface/hoop-interface.kicad_pcb (2026-03-06)

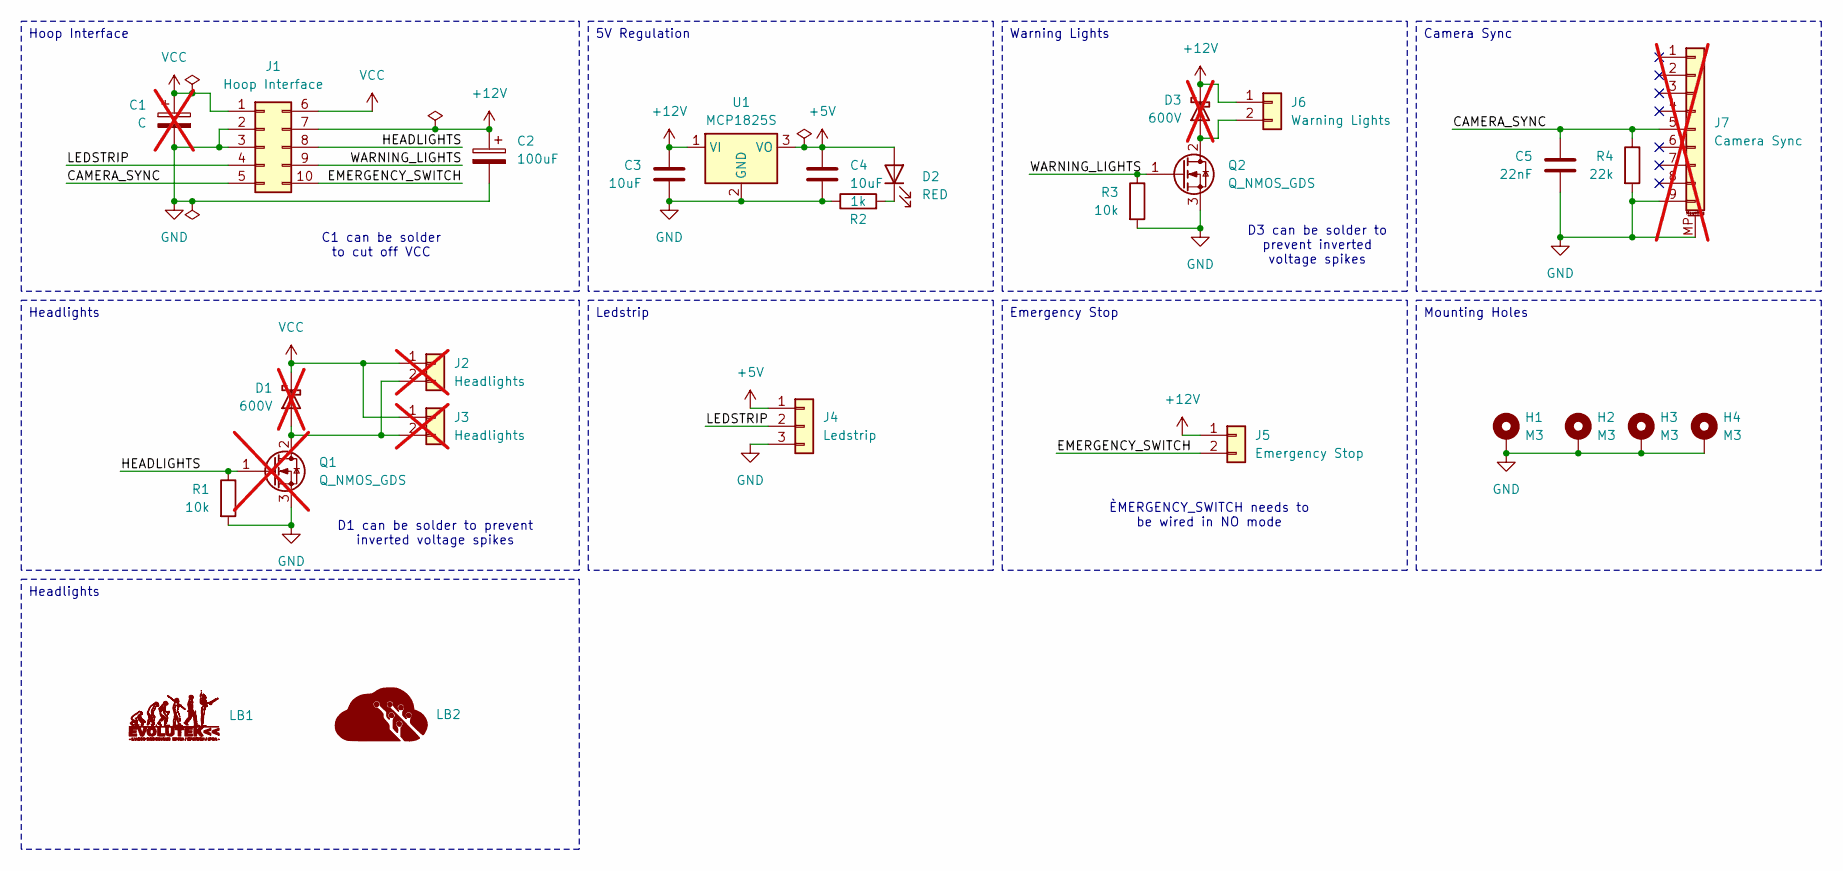
[picture p17: schematic hoop-interface.kicad_sch, Hoop Interface]

Parts:
C1: C; CP_Radial_D10.0mm_P5.00mm; not fitted
C2: 100uF; CP_Elec_6.3x7.7
C3, C4: 10uF; C_0603_1608Metric
C5: 22nF; C_0603_1608Metric
D1, D3: 600V; D_SMB; not fitted
D2: RED; LED_0805_2012Metric
H1, H2, H3, H4: M3; MountingHole_3.2mm_M3_Pad_Via
J1: Hoop Interface; 66201021022
J2, J3: Headlights; 66200221022; not fitted
J4: Ledstrip; B03B-PASK
J5: Emergency Stop; 66200221022
J6: Warning Lights; 66200221022
J7: Camera Sync; JST_SH_BM09B-SRSS-TB_1x09-1MP_P1.00mm_Vertical; not fitted
LB1: LOGO; logo-evo-micro
LB2: LOGO; Logo Aisler Micro
Q1: Q_NMOS_GDS; SOT-223-3_TabPin2; not fitted
Q2: Q_NMOS_GDS; SOT-223-3_TabPin2
R1, R3: 10k; R_0603_1608Metric
R2: 1k; R_0603_1608Metric
R4: 22k; R_0603_1608Metric
U1: MCP1825S; SOT-223-3_TabPin2

Connections:
+5V: C4.1, D2.2 (A), J4.1, U1.3 (VO)
+12V: C2.1, C3.1, D3.1 (K), J1.7, J5.1, J6.1, U1.1 (VI)
/CAMERA_SYNC: C5.1, J1.5, J7.5, R4.1
/EMERGENCY_SWITCH: J1.10, J5.2
/HEADLIGHTS: J1.8, Q1.1 (G), R1.1
/LEDSTRIP: J1.4, J4.2
/WARNING_LIGHTS: J1.9, Q2.1 (G), R3.1
GND: C1.2, C2.2, C3.2, C4.2, C5.2, H1.1, H2.1, H3.1, H4.1, J1.2, J1.3, J4.3, J7.9, J7.MP (MountPin), Q1.3 (S), Q2.3 (S), R1.2, R2.1, R3.2, R4.2, U1.2 (GND)
unnamed: D1.2 (A), J2.2, J3.2, Q1.2 (D)
unnamed: D2.1 (K), R2.2
unnamed: D3.2 (A), J6.2, Q2.2 (D)
VCC: C1.1, D1.1 (K), J1.1, J1.6, J2.1, J3.1

Notes on the sheet:
D1 can be solder to prevent inverted voltage spikes
C1 can be solder to cut off VCC
ÈMERGENCY_SWITCH needs to be wired in NO mode
D3 can be solder to prevent inverted voltage spikes
Emergency Stop
Ledstrip
Warning Lights
5V Regulation
Headlights
Mounting Holes
Hoop Interface
Camera Sync

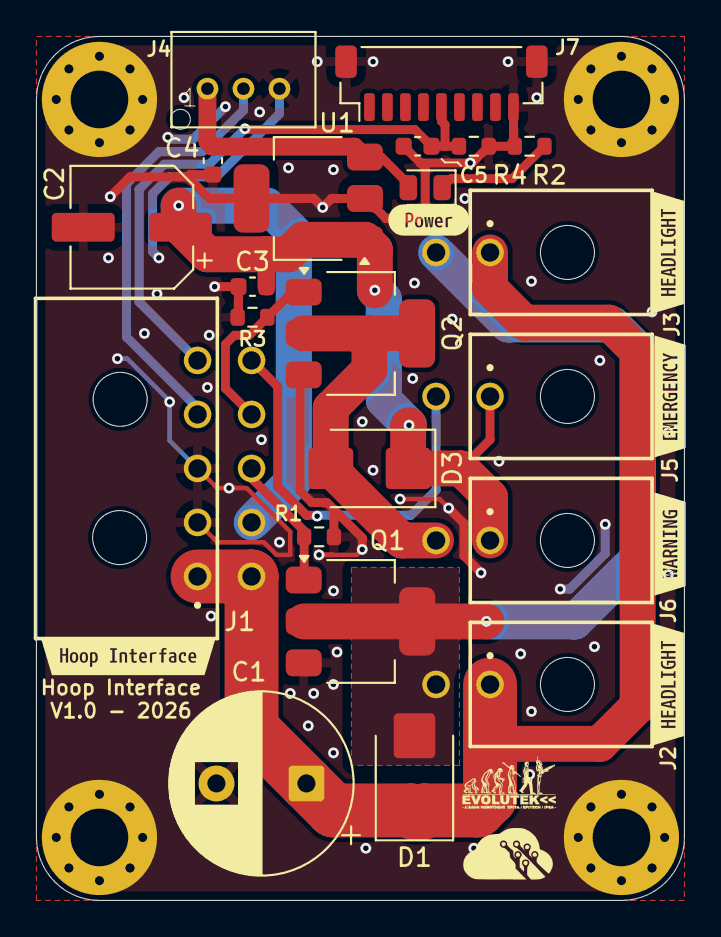
[picture p18: board hoop-interface.kicad_pcb from above]

Board: 2 copper layers, 36.0 x 48.0 mm, 34 parts (0 on the bottom side), 12 nets.

Other parts of the board:
kibuzzard-69584B36: G***; kibuzzard-69584B36
kibuzzard-69584B63, kibuzzard-69584B63#2: G***; kibuzzard-69584B63
kibuzzard-69584B83: G***; kibuzzard-69584B83
kibuzzard-69584BC4: G***; kibuzzard-69584BC4
kibuzzard-69584D60: G***; kibuzzard-69584D60
