evolutek/cartolutek-hardware/RPI Interface/RPI_Interface.kicad_pcb

## KiCad design RPI Interface/RPI_Interface.kicad_pcb (2026-03-06)

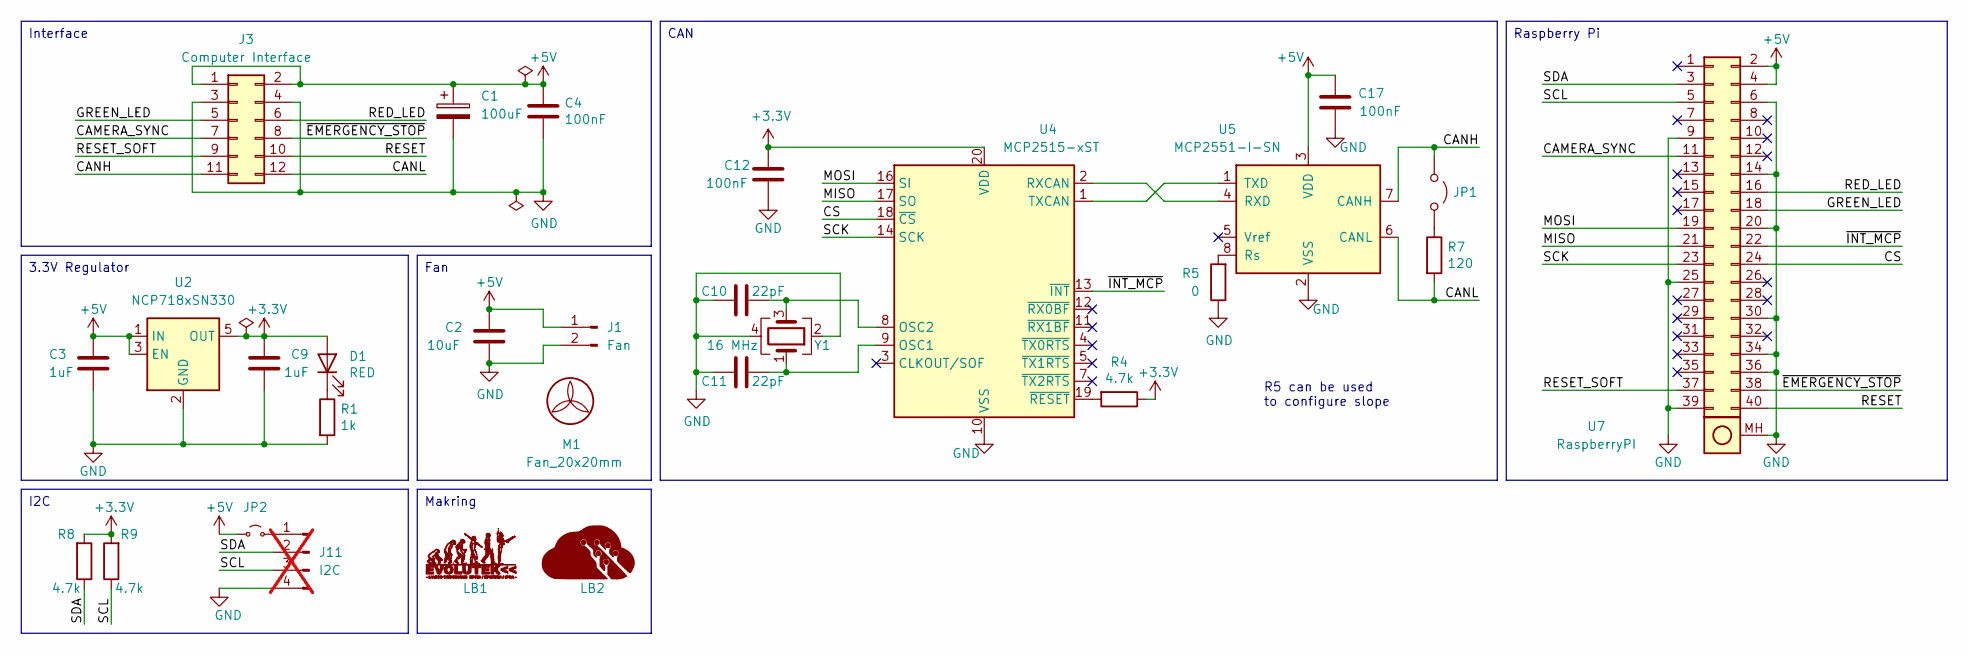
[picture p19: schematic RPI_Interface.kicad_sch, RPI Interface]

Parts:
C1: 100uF; CP_Elec_6.3x7.7
C2: 10uF; C_0603_1608Metric
C3, C9: 1uF; C_0603_1608Metric
C4, C12, C17: 100nF; C_0603_1608Metric
C10, C11: 22pF; C_0603_1608Metric
D1: RED; LED_0805_2012Metric
J1: Fan; JST_XH_B2B-XH-AM_1x02_P2.50mm_Vertical
J3: Computer Interface; J_Wurth_WR-MM_690367281276
J11: I2C; B04B-PASK; not fitted
JP1: Jumper_2_Open; PinHeader_1x02_P2.54mm_Vertical
JP2: Jumper_2_Small_Open; PinHeader_1x02_P2.54mm_Vertical
LB1: LOGO; logo-evo-micro
LB2: LOGO; Logo Aisler Micro
M1: Fan_20x20mm; 40x40x10_DC_FAN
R1: 1k; R_0603_1608Metric
R4, R8, R9: 4.7k; R_0603_1608Metric
R5: 0; R_0603_1608Metric
R7: 120; R_0603_1608Metric
U2: NCP718xSN330; SOT-23-5
U4: MCP2515-xST; TSSOP-20_4.4x6.5mm_P0.65mm
U5: MCP2551-I-SN; SOIC-8_3.9x4.9mm_P1.27mm
U7: RaspberryPI; Shield_Raspberry_Pi_with_11mm_Header
Y1: 16 MHz; Crystal_SMD_5032-4Pin_5.0x3.2mm

Connections:
+3.3V: C9.1, C12.1, D1.2 (A), R4.1, R8.2, R9.2, U2.5 (OUT), U4.20 (VDD)
+5V: C1.1, C2.1, C3.1, C4.1, C17.2, J1.1, J3.1, J3.2, JP2.1 (A), U2.1 (IN), U2.3 (EN), U5.3 (VDD), U7.2, U7.4
/ ~EMERGENCY_STOP: U7.38
/ ~EMERGENCY_STOP: J3.8
/CAMERA_SYNC: J3.7, U7.11
/CANH: J3.11, JP1.1 (A), U5.7 (CANH)
/CANL: J3.12, R7.2, U5.6 (CANL)
/CS: U4.18 (~CS), U7.24
/GREEN_LED: J3.5, U7.18
/MISO: U4.17 (SO), U7.21
/MOSI: U4.16 (SI), U7.19
/RED_LED: J3.6, U7.16
/RESET: J3.10, U7.40
/RESET_SOFT: J3.9, U7.37
/SCK: U4.14 (SCK), U7.23
/SCL: J11.3, R9.1, U7.5
/SDA: J11.2, R8.1, U7.3
/~INT_MCP: U4.13 (~INT), U7.22
GND: C1.2, C2.2, C3.2, C4.2, C9.2, C10.2, C11.2, C12.2, C17.1, J1.2, J3.3, J3.4, J11.4, R1.2, R5.1, U2.2 (GND), U4.10 (VSS), U5.2 (VSS), U7.6, U7.9, U7.14, U7.20, U7.25, U7.30, U7.34, U7.36, U7.39, U7.MH (MountingHoles), Y1.2, Y1.4
unnamed: D1.1 (K), R1.1
unnamed: J11.1, JP2.2 (B)
unnamed: JP1.2 (B), R7.1
unnamed: C11.1, U4.9 (OSC1), Y1.1
unnamed: C10.1, U4.8 (OSC2), Y1.3
unnamed: U4.2 (RXCAN), U5.4 (RXD)
unnamed: U4.1 (TXCAN), U5.1 (TXD)
unnamed: R4.2, U4.19 (~RESET)
unnamed: R5.2, U5.8 (Rs)

Notes on the sheet:
R5 can be used to configure slope
I2C
Interface
Fan
Makring
Raspberry Pi
3.3V Regulator
CAN

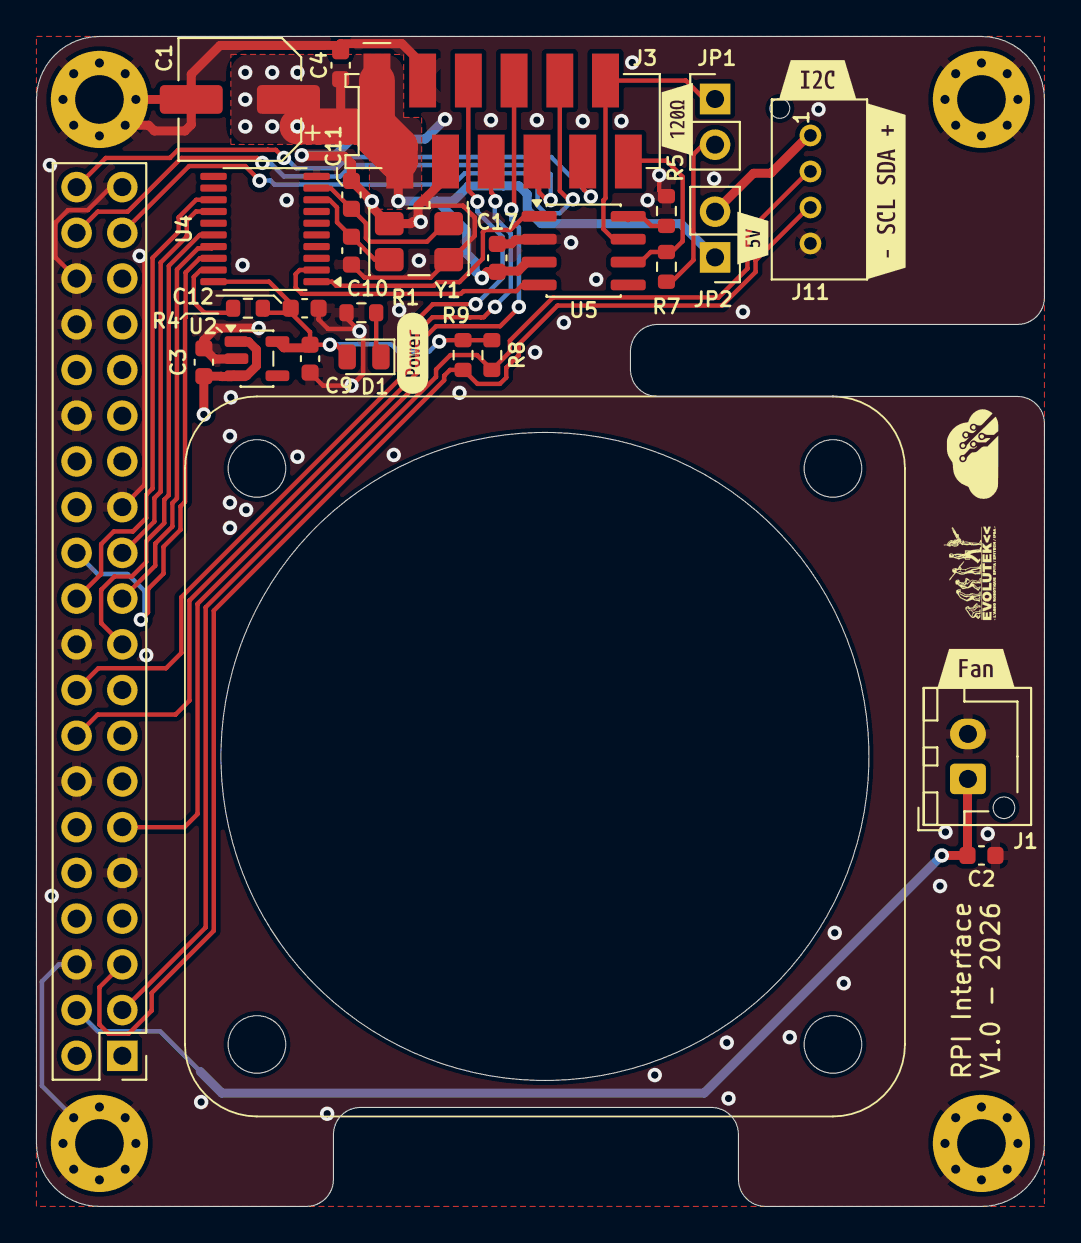
[picture p20: board RPI_Interface.kicad_pcb from above]

Board: 2 copper layers, 56.0 x 65.0 mm, 35 parts (0 on the bottom side), 26 nets.

Other parts of the board:
kibuzzard-693864F8: G***; kibuzzard-693864F8
kibuzzard-693865CE: G***; kibuzzard-693865CE
kibuzzard-693865DC: G***; kibuzzard-693865DC
kibuzzard-693867AF: G***; kibuzzard-693867AF
kibuzzard-693867E9: G***; kibuzzard-693867E9
kibuzzard-69386806: G***; kibuzzard-69386806
