evolutek/cartolutek-hardware/UI Interface/ui-interface.kicad_pcb

## KiCad design UI Interface/ui-interface.kicad_pcb (2026-01-27)

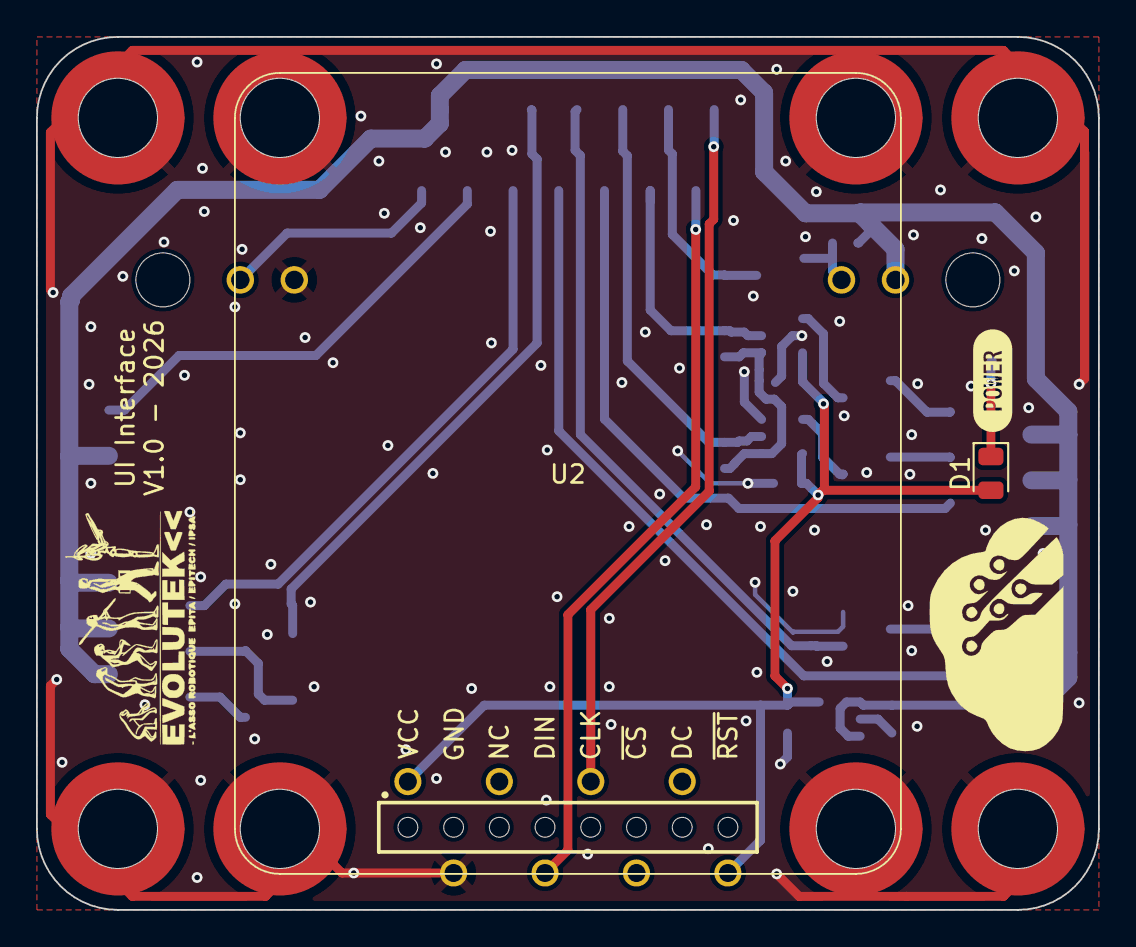
[picture p21: board ui-interface.kicad_pcb from above]

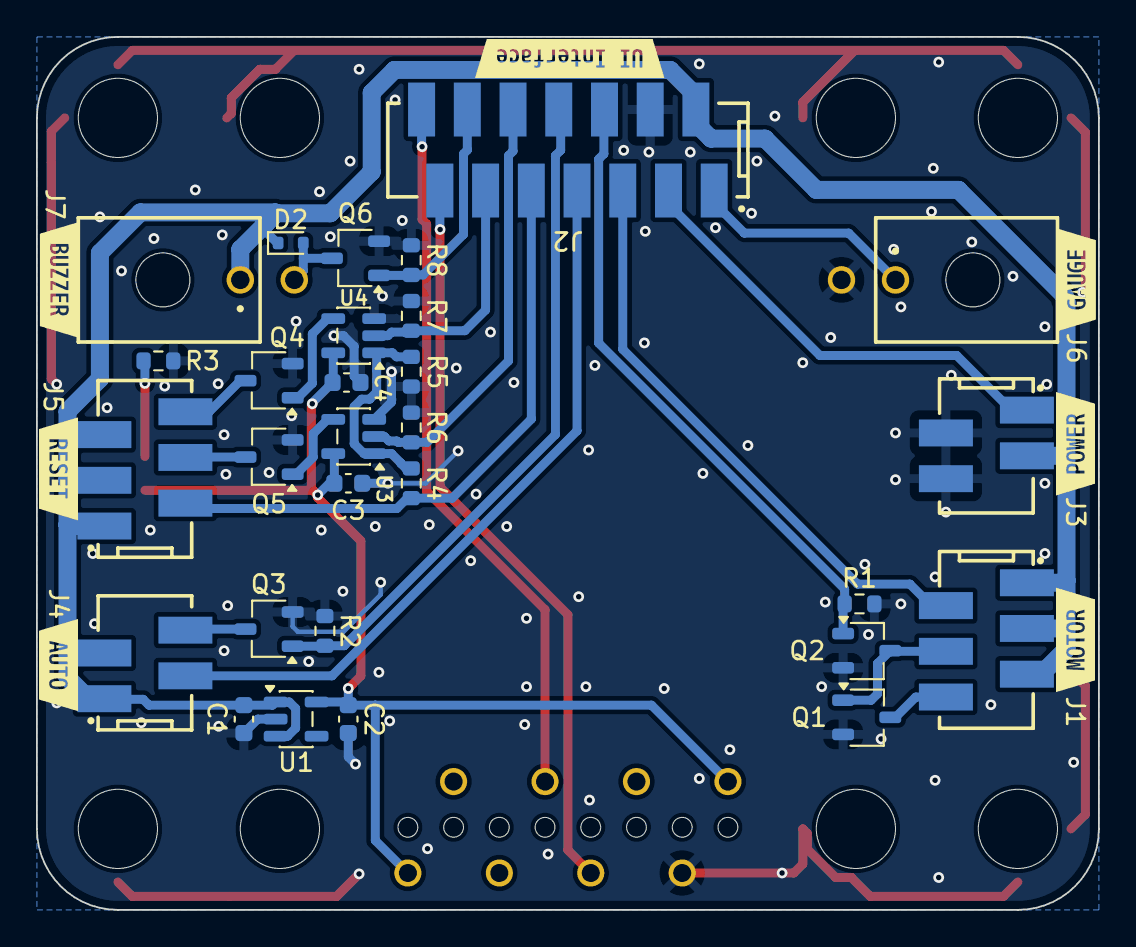
[picture p22: board ui-interface.kicad_pcb from below]

Board: 2 copper layers, 59.0 x 48.5 mm, 45 parts (36 on the bottom side), 25 nets.

Parts:
C1, C2: 1uF; C_0603_1608Metric
C3, C4: 100nF; C_0603_1608Metric
D1: RED; LED_0805_2012Metric
D2: D_Schottky; D_SOD-523
H1, H2, H3, H4: M3; WA-SMSI_9774110360
J1: Motor Power Switch; 690367280676
J2: UI Interface; 690367281476
J3: Power Switch; 690367280476
J4: Auto Mode Switch; 690367280476
J5: Reset Switch; 690367280676
J6: Battery Gauge; 66200221022
J7: Buzzer; 66200221022
LB1: LOGO; Logo Aisler Min
LB2: LOGO; logo-evo-min
Q1, Q2, Q3, Q4, Q5, Q6: Q_NMOS_GSD; TSOT-23
R1, R2, R5, R6, R7, R8: 10k; R_0603_1608Metric
R3: 510; R_0603_1608Metric
R4: 33k; R_0603_1608Metric
U1: NCP718xSN330; SOT-23-5
U2: Waveshare_1.5_inch_OLED; Waveshare 1.5 inch with 8mm spacers
U3, U4: SN74LVC1G32; SOT-23-5
kibuzzard-69598A88: G***; kibuzzard-69598A88
kibuzzard-69598DA4: G***; kibuzzard-69598DA4
kibuzzard-695995E5: G***; kibuzzard-695995E5
kibuzzard-695995F9: G***; kibuzzard-695995F9
kibuzzard-6959960F: G***; kibuzzard-6959960F
kibuzzard-69599623: G***; kibuzzard-69599623
kibuzzard-69599634: G***; kibuzzard-69599634
kibuzzard-69599736: G***; kibuzzard-69599736

Connections:
+3.3V: C2.1, C3.1, C4.1, D1.2 (A), U1.5 (OUT), U2.1 (VCC), U2.8 (~RST), U3.5 (VCC), U4.5 (VCC)
+12V: C1.1, D2.1 (K), J1.1, J1.3, J1.5, J2.2, J3.3, J4.1, J4.3, J5.1, J5.3, J5.5, J7.1, U1.1 (IN), U1.3 (EN)
/AUTO_MODE_ENABLE: J2.8, Q3.1 (G), R2.1
/AUTO_MODE_SWITCH: J2.7, J4.2
/BUZZER: J2.12, Q6.1 (G), R8.1
/GREEN: J1.4, Q1.1 (G), Q2.3 (D)
/GREEN_LED: J2.10, R6.1, U3.2 (B)
/MOTOR_POWER_ENABLE: J2.6, Q2.1 (G), R1.1
/MOTOR_POWER_SWITCH: J1.2, J2.5
/RED: J1.6, Q1.3 (D)
/RED_LED: J2.11, R7.1, U4.2 (B)
/RESET: J2.9, J5.2, R4.1
/SCL: J2.14, U2.5 (CLK)
/SDA: J2.13, U2.4 (DIN)
/~POWER_SWITCH: J2.3, J3.1
GND: C1.2, C2.2, C3.2, C4.2, H1.1, H2.1, H3.1, H4.1, J2.4, J3.2, J3.4, J6.2, Q1.2 (S), Q2.2 (S), Q3.2 (S), Q4.2 (S), Q5.2 (S), Q6.2 (S), R1.2, R2.2, R3.2, R5.2, R6.2, R7.2, R8.2, U1.2 (GND), U2.2 (GND), U2.MP, U3.3 (GND), U4.3 (GND)
unnamed: D1.1 (K), R3.1
unnamed: D2.2 (A), J7.2, Q6.3 (D)
unnamed: J4.4, Q3.3 (D)
unnamed: J5.4, Q5.3 (D)
unnamed: J5.6, Q4.3 (D)
unnamed: Q4.1 (G), U4.4 (S)
unnamed: Q5.1 (G), U3.4 (S)
unnamed: R4.2, R5.1, U3.1 (A), U4.1 (A)
VCC: J2.1, J6.1
