evolutek/cartolutek-hardware/Carte Moteur/carte-moteur.kicad_pcb

## KiCad design Carte Moteur/carte-moteur.kicad_pcb (2025-06-11)

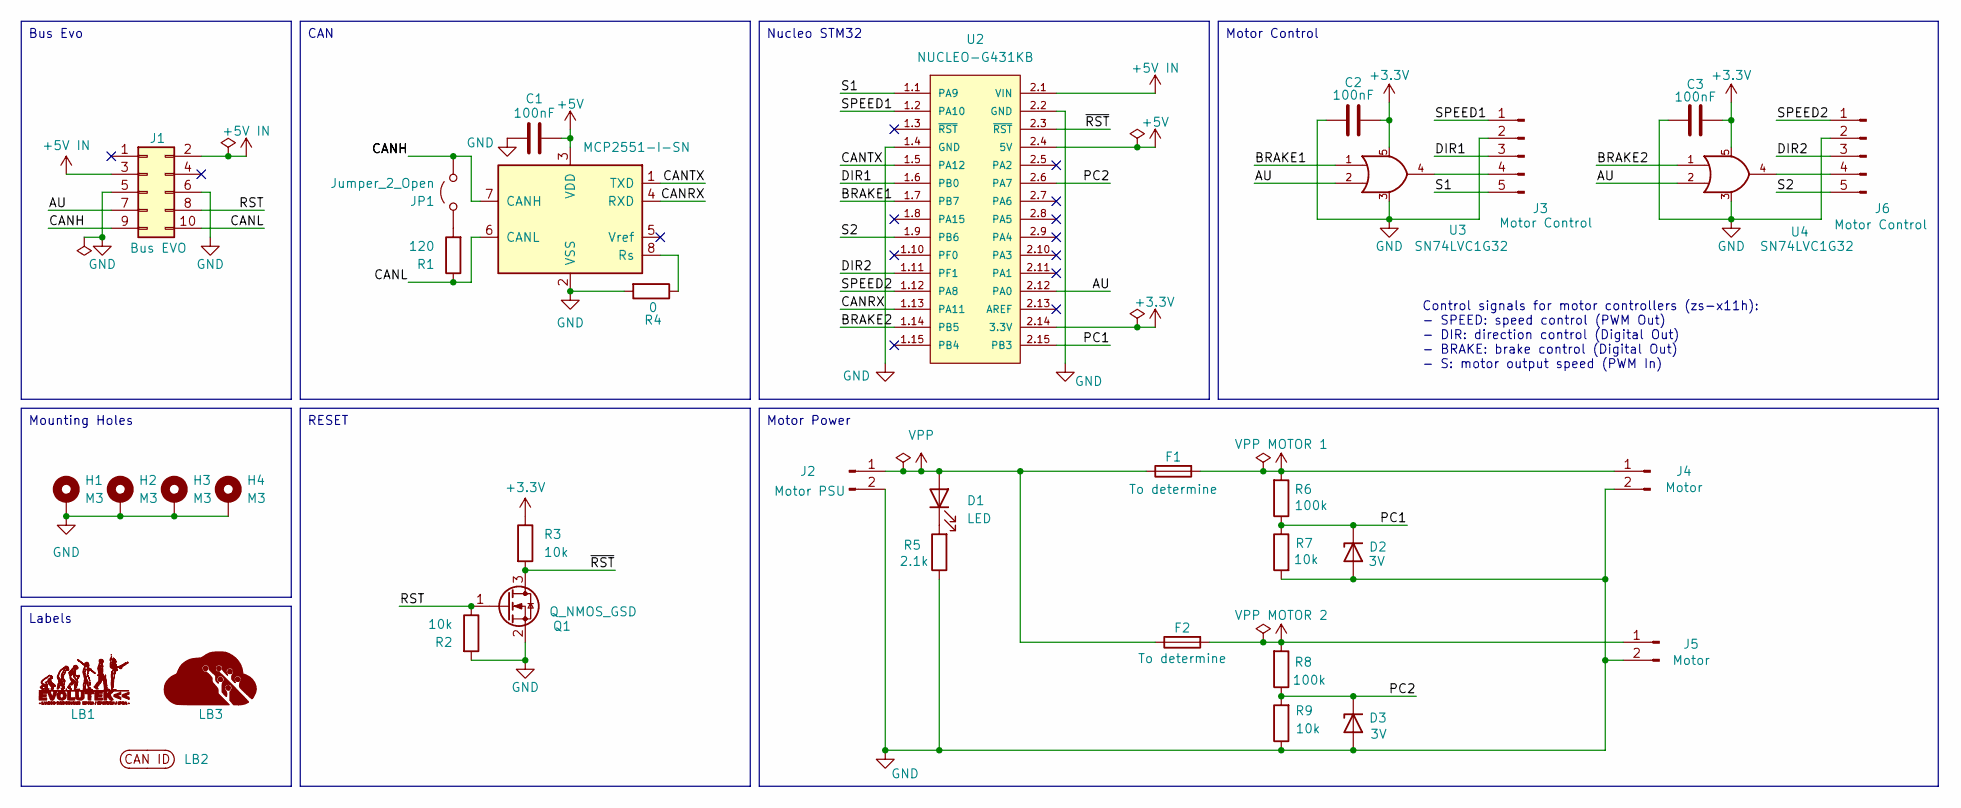
[picture p23: schematic carte-moteur.kicad_sch, Carte Moteur]

Parts:
C1, C2, C3: 100nF; C_0603_1608Metric
D1: LED; LED_0805_2012Metric
D2, D3: 3V; D_SOD-523
F1, F2: To determine; FUSE_3557-2
H1, H2, H3, H4: M3; MountingHole_3.2mm_M3_Pad_Via
J1: Bus EVO; 690367281076
J2: Motor PSU; 657002140101
J3, J6: Motor Control; B05B-PASK
J4, J5: Motor; 657002140101
JP1: Jumper_2_Open; PinHeader_1x02_P2.54mm_Vertical
LB1: LOGO; logo-evo-micro
LB2: CAN ID Label
LB3: LOGO; Logo Aisler Micro
Q1: Q_NMOS_GSD; SOT-23
R1: 120; R_0603_1608Metric
R2, R3, R7, R9: 10k; R_0603_1608Metric
R4: 0; R_0603_1608Metric
R5: 2.1k; R_0603_1608Metric
R6, R8: 100k; R_0603_1608Metric
U1: MCP2551-I-SN; SOIC-8_3.9x4.9mm_P1.27mm
U2: NUCLEO-G431KB; MODULE_NUCLEO-32
U3, U4: SN74LVC1G32; SOT-23-5

Connections:
+3.3V: C2.1, C3.1, R3.1, U2.2.14 (3.3V), U3.5 (VCC), U4.5 (VCC)
+5V: C1.1, U1.3 (VDD), U2.2.4 (5V)
+5V IN: J1.2, J1.3, U2.2.1 (VIN)
/AU: J1.7, U2.2.12 (PA0), U3.2 (B), U4.2 (B)
/BRAKE1: U2.1.7 (PB7), U3.1 (A)
/BRAKE2: U2.1.14 (PB5), U4.1 (A)
/CANH: J1.9, JP1.2 (B), U1.7 (CANH)
/CANL: J1.10, R1.1, U1.6 (CANL)
/CANRX: U1.4 (RXD), U2.1.13 (PA11)
/CANTX: U1.1 (TXD), U2.1.5 (PA12)
/DIR1: J3.3, U2.1.6 (PB0)
/DIR2: J6.3, U2.1.11 (PF1)
/PC1: D2.1 (K), R6.1, R7.1, U2.2.15 (PB3)
/PC2: D3.1 (K), R8.1, R9.2, U2.2.6 (PA7)
/RST: J1.8, Q1.1 (G), R2.1
/S1: J3.5, U2.1.1 (PA9)
/S2: J6.5, U2.1.9 (PB6)
/SPEED1: J3.1, U2.1.2 (PA10)
/SPEED2: J6.1, U2.1.12 (PA8)
/~RST: Q1.3 (D), R3.2, U2.2.3 (~RST)
GND: C1.2, C2.2, C3.2, D2.2 (A), D3.2 (A), H1.1, H2.1, H3.1, H4.1, J1.5, J1.6, J2.2, J3.2, J4.2, J5.2, J6.2, Q1.2 (S), R2.2, R4.2, R5.1, R7.2, R9.1, U1.2 (VSS), U2.1.4 (GND), U2.2.2 (GND), U3.3 (GND), U4.3 (GND)
unnamed: D1.1 (K), R5.2
unnamed: J3.4, U3.4 (S)
unnamed: J6.4, U4.4 (S)
unnamed: JP1.1 (A), R1.2
unnamed: R4.1, U1.8 (Rs)
VPP: D1.2 (A), F1.1, F2.1, J2.1
VPP MOTOR 1: F1.2, J4.1, R6.2
VPP MOTOR 2: F2.2, J5.1, R8.2

Notes on the sheet:
Control signals for motor controllers (zs-x11h): - SPEED: speed control (PWM Out) - DIR: direction control (Digital Out) - BRAKE: brake control (Digital Out) - S: motor output speed (PWM In)
Motor Control
Mounting Holes
Labels
Nucleo STM32
Bus Evo
Motor Power
CAN
RESET

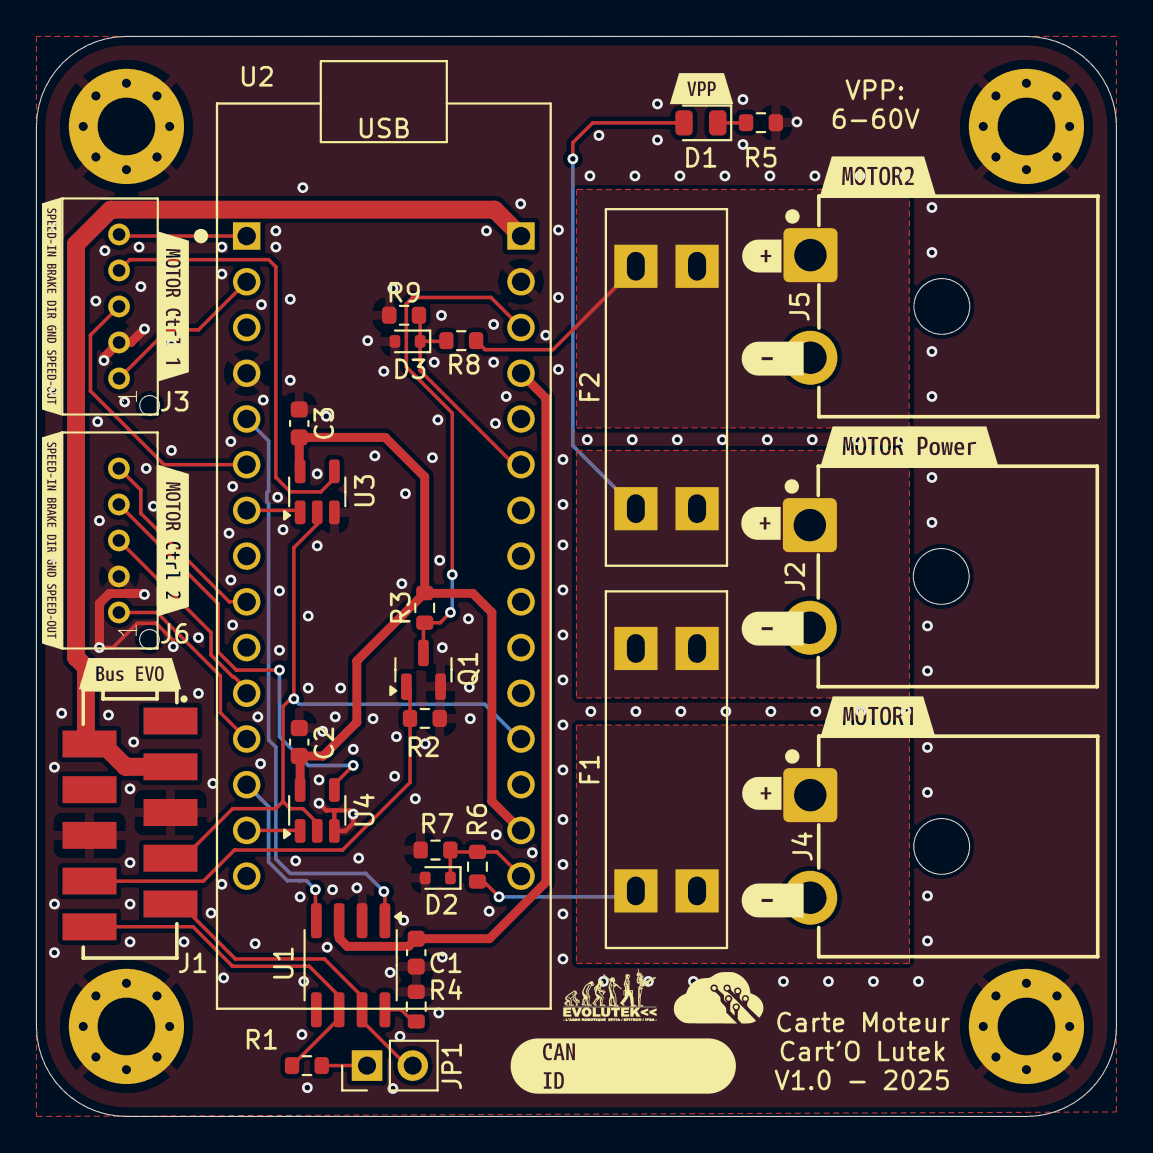
[picture p24: board carte-moteur.kicad_pcb from above]

Board: 2 copper layers, 60.0 x 60.0 mm, 51 parts (0 on the bottom side), 29 nets.

Other parts of the board:
kibuzzard-6849F6E8: G***; kibuzzard-6849F6E8
kibuzzard-6849F8B2: G***; kibuzzard-6849F8B2
kibuzzard-6849F8DE: G***; kibuzzard-6849F8DE
kibuzzard-6849F74E: G***; kibuzzard-6849F74E
kibuzzard-6849F710: G***; kibuzzard-6849F710
kibuzzard-6849F726: G***; kibuzzard-6849F726
kibuzzard-6849FC70, kibuzzard-6849FC70#2, kibuzzard-6849FC70#3: G***; kibuzzard-6849FC70
kibuzzard-6849FC90, kibuzzard-6849FC90#2, kibuzzard-6849FC90#3: G***; kibuzzard-6849FC90
kibuzzard-6849FDBB: G***; kibuzzard-6849FDBB
kibuzzard-6849FECA, kibuzzard-6849FECA#2: G***; kibuzzard-6849FECA
