evolutek/cartolutek-hardware/Mainboard/Mainboard.ioc

Mcu.UserName=STM32G491KEUx
PA0.GPIO_Label=BATTERY_VOLTAGE
PA0.Signal=ADC1_IN1
PA1.GPIO_Label=EMMERGENCY_STOP
PA1.Signal=GPXTI1
PA10.GPIO_Label=STATUS
PA10.Signal=GPIO_Output
PA11.Signal=USB_DM
PA12.Signal=USB_DP
PA13.Signal=SYS_JTMS-SWDIO
PA14.Signal=SYS_JTCK-SWCLK
PA15.GPIO_Label=WARNING_LIGHTS
PA15.Signal=S_TIM8_CH1
PA2.GPIO_Label=VCP_TX
PA2.Signal=USART2_TX
PA3.GPIO_Label=VCP_RX
PA3.Signal=USART2_RX
PA4.GPIO_Label=BUZZER
PA4.Signal=COMP_DAC11_group
PA5.GPIO_Label=HEADLIGHT
PA5.Signal=S_TIM2_CH1
PA6.GPIO_Label=MOTOR_POWER_ENABLE
PA6.Signal=GPIO_Output
PA7.GPIO_Label=MANUAL_MODE_ENABLE
PA7.Signal=GPIO_Output
PA8.Signal=I2C2_SDA
PA9.Signal=I2C2_SCL
PB0.GPIO_Label=MOTOR_POWER_SWITCH
PB0.Signal=GPXTI0
PB3.GPIO_Label=MANUAL_MODE_SWITCH
PB3.Signal=GPXTI3
PB4.GPIO_Label=LEDSTRIP_FRONT
PB4.Signal=S_TIM3_CH1
PB5.Signal=FDCAN2_RX
PB6.Signal=FDCAN2_TX
PB7.GPIO_Label=LEDSTRIP_BACK
PB7.Signal=S_TIM4_CH2
