evolutek/cartolutek-hardware/(commit log)

2025-05-11 Carte moteur à review
    [Carte moteur.kicad_pcb, Carte moteur.kicad_sch]
2025-05-18 Correctifs carte moteur
    [Carte moteur.kicad_pcb, Carte moteur.kicad_sch]
2025-06-10 Correctifs pour review finale
    [Carte moteur.kicad_pcb]
2025-06-11 Release V1.0
    [Carte moteur.kicad_pcb, Carte moteur.kicad_sch]
2025-12-24 Rename folder to tmp name
    [Carte Moteur.kicad_pcb, Carte Moteur.kicad_sch]
2025-12-24 Rename folder to correct name
    [Carte Moteur.kicad_pcb, Carte Moteur.kicad_sch]
2025-12-24 Rename files
    [carte-moteur.kicad_pcb, carte-moteur.kicad_sch]
2026-01-27 Schematics for UI Interface
    [ui-interface.kicad_pcb, ui-interface.kicad_sch]
2026-01-27 Update schematics
    [ui-interface.kicad_sch]
2026-01-27 Minor fixes
    [ui-interface.kicad_sch]
2026-01-27 UI Interface V1.0
    [ui-interface.kicad_pcb, ui-interface.kicad_sch]
2026-01-27 Fix bad reference
    [ui-interface.kicad_pcb, ui-interface.kicad_sch]
2026-01-27 Fix silkscreen
    [ui-interface.kicad_pcb]
2026-03-06 WIP RPI Interface
    [RPI_Interface.kicad_pcb, RPI_Interface.kicad_sch]
2026-03-06 V1.0 of RPI Interface
    [RPI_Interface.kicad_pcb, RPI_Interface.kicad_sch]
2026-03-06 Export schematics
2026-03-06 RPI Interface V1.0
    [RPI_Interface.kicad_pcb, RPI_Interface.kicad_sch]
2026-03-06 Minor fix in the schematics
    [RPI_Interface.kicad_pcb, RPI_Interface.kicad_sch]
2026-03-06 WIP hoop interface
    [hoop-interface.kicad_pcb, hoop-interface.kicad_sch]
2026-03-06 Hoop Interface V1.0
    [hoop-interface.kicad_pcb, hoop-interface.kicad_sch, hoop-interface.step]
2026-03-06 Update res value
    [hoop-interface.kicad_pcb, hoop-interface.kicad_sch]
2026-03-06 Fix schematics
    [hoop-interface.kicad_sch]
2026-03-06 WIP Schematics
    [Mainboard.kicad_pcb, Mainboard.kicad_sch, bus_evo.kicad_sch, computer_interface.kicad_sch, hoop_interface.kicad_sch, interface_ui.kicad_sch, logic.kicad_sch, power.kicad_sch]
2026-03-06 Schematics almost done
    [Mainboard.kicad_sch, bus_evo.kicad_sch, computer_interface.kicad_sch, hoop_interface.kicad_sch, interface_ui.kicad_sch, interfaces.kicad_sch, logic.kicad_sch, power.kicad_sch]
2026-03-06 Update footprints and correct minor mistakes
    [interfaces.kicad_sch, logic.kicad_sch, power.kicad_sch]
2026-03-06 Schematics before routing
    [Mainboard.kicad_sch, interfaces.kicad_sch, logic.kicad_sch, power.kicad_sch]
2026-03-06 Minor fixes and pre-placement
    [Mainboard.kicad_pcb, Mainboard.kicad_sch, power.kicad_sch]
2026-03-06 Minor fixes in schematics
    [Mainboard.kicad_sch, interfaces.kicad_sch, logic.kicad_sch, power.kicad_sch]
2026-03-06 WIP routing
    [Mainboard.kicad_pcb, Mainboard.kicad_sch, power.kicad_sch]
2026-03-06 Redesign power decoupling for VCC and VPP
    [Mainboard.kicad_sch, interfaces.kicad_sch, logic.kicad_sch, power.kicad_sch]
2026-03-06 WIP PCB
    [Mainboard.kicad_pcb]
2026-03-06 Rounting done
    [Mainboard.kicad_pcb]
2026-03-06 Mainboard V1.0
    [Mainboard.kicad_pcb, Mainboard.kicad_sch, interfaces.kicad_sch, logic.kicad_sch, power.kicad_sch]
